CaliBeta/Control_PID_modular/README.md

# Control_PID_modular
Controlador PID analogo y digital para tres plantas de diferente respuesta. las ganancias se varían mediante potenciometros digitales
