CaliBeta/Control_PID_modular/Info/acciones_control.pdf

Proyecto Banco PID | 1

# Diseno sistema de control PID para la planta numero1

1. analisis de la planta en lazo abierto

La planta a controlar es un sistema en segundo orden cuya funcion de transferencia esta dada por:

1
s

2+s−2

R(s) | Y (s)

Graficando Los polos de la planta se analiza que el sistema es Inestable, con un polo en el semiplano positivo sin parte imaginaria. segun esto, la respuesta ante el escalon debe ser una exponencial hacia el infinito sin amortiguamiento.

los polos son:

s = −2

s = 1

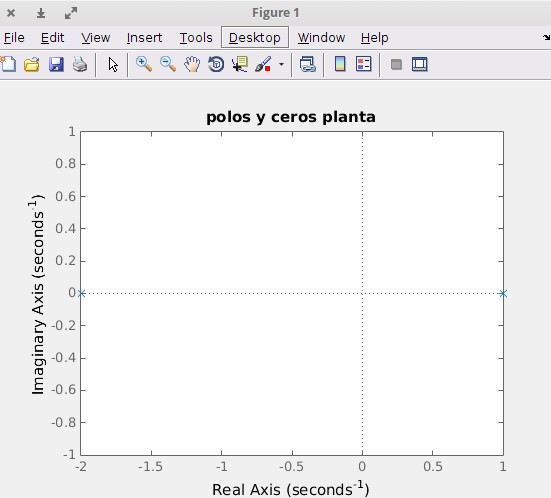
[picture p15: figure]

Con Matlab, se grafica la respuesta ante una entrada escalon unitario analizando que el sistema se Inestabiliza al infinito sin amortiguamiento:

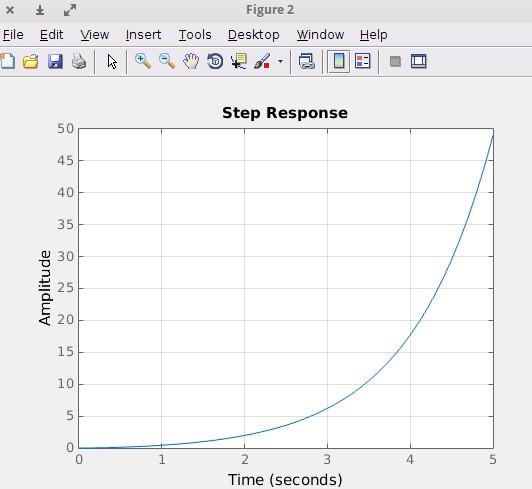
[picture p16: figure]

2. planta 1 con el controlador

Para controlar la planta, entonces realimentamos el sistema con el controlador PID:

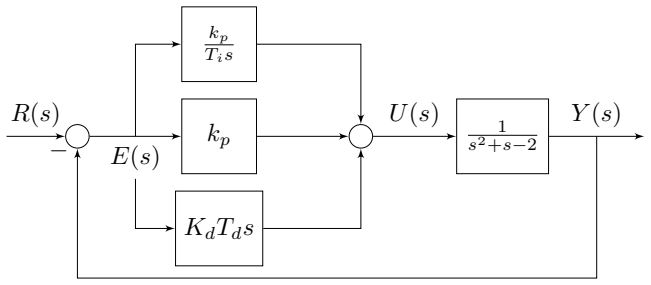
[picture p17: figure]
kp Tis; KdTds

Resolviendo los bloques del controlador:

kpTiTds

2+kpTis+kp
Tis

1
s

2+s−2

R(s)

E(s)

U(s) | Y (s)
−

Resolviendo la realimentacion:

## kpTiTd

s

## 2+kpTis+kp

## Tis

## 3+(Ti+kpTiTd

)s

## 2+(kpTi−2Ti )s+kp

R(s) | Y (s)

Dividiendo por Ti con el fin de dejar s

3
solo, se tiene la funcion de transferencia planta-controlador o controlada.

## kpTd

s

## 2+kps+

kp
Ti
s

## 3+(1+kpTd

)s

## 2+(kp−2)s+

kp
Ti
R(s) | Y (s)

nota: en este momento ya se tiene la funcion de transferencia de la planta con el bloque de control. es necesario hallar los parametros KpTiT d

3. Funcion de transferencia deseada

Segun las especificacion de diseno se requiere que el sistema responda con un tiempo de establecimiento T s deseado, ademas el sobrepaso deseado Mp.

Para esto se hace una funcion de transferencia deseada de segundo orden, para asi comparar con la planta controlada y definir los parametros de control.

Segn la forma canonica de un sistema de orden 2:

kwn

2
s

2+2ζwns+wn

2

El factor de amortiguamiento ζ lo definimos de 0.8 con el fin de que la respuesta sea subamortiguada con un bajo sobrepaso

ζ = 0.8

El tiempo de establecimiento o tiempo cuando la senal alcanza un error maximo del 2 porciento denminado Ts sera 5s, para esto se usa:

Ts = 4τ ⇒ τ =

1
ζwn ⇒ Ts =

4
ζwn

despejando wn:

wn =

4
ζTs ⇒ wn =

4
(0.8)(5) ⇒ wn = 1

reemplazando los valores en la forma canonica

kwn

2
s

2+2ζwns+wn

2 ⇒ | (1)(1)²
s
| 2+2(0.8)(1)s+1²

La funcion de transferencia deseada sera:

1
s

2+1.6s+1

si queremos comparar esta funcion de transferencia deseada de orden 2 con la funcion de transferencia planta-controlador o controlada de orden 3 no podriamos. tendriamos que aumentar el orden a la deseada. para esto colocamos un polo 10 veces mas alejado del ultimo polo de la deseada.

hallamos los polos de la deseada:

s = 0.8 ± 0.6j

entonces:

1
s
2+1.6s+1 ⇒ | 1
(s+0.8+0.6j)(s+8−0.6j)

un polo 10 veces mas alejado sin parte imaginaria y multiplicamos por el valor del polo en el numerador con el fin de mantener wn

2
tanto en el numerador y denominador. Aumentando el orden del sistema con el polo alejado:

1(8)
(s+0.8+0.6j)(s+0.8−0.6j)(s+8) ⇒ | 1(8)
(s

2+1.6s+1)(s+8)

la funcion de transferencia deseada sera entonces:

8
s

3+9.6s

2+13.8s+8

Graficando la respuesta al escalon de la deseada y la deseada aumentada con un polo 10 veces mayor, vemos que la respuesta deseada cumple los requerimientos y no son muy diferentes una con otra:

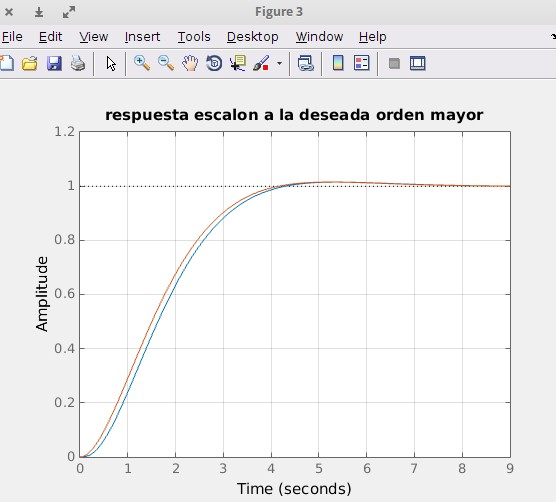
[picture p18: figure]

4. comparando la deseada aumentada con la planta-controlador

ya tenemos la funcion de transferencia controlada y la funcion de transferencia a la cual quermos llegar si las comparamos asi:

kpTds

2+kps+

kp
Ti
s

3+(1+kpTd)s

2+(kp−2)s+

kp
Ti
⇐⇒ | 8
s

3+9.6s

| 2+13.8s+8

comparando la ecuacion caracteristica o denominador:

s

3 + (1 + kpTd)s

2 + (kp − 2)s +

kp

### Ti ⇐⇒ s

3 + 9.6s

2 + 13.8s + 8

igualando tenemos que:

kp − 2 = 13.8 ⇒ kp = 13.8 + 2 ⇒ kp = 15.8

kp
Ti

= 8 ⇒ Ti =

kp
8 ⇒ Ti =

15.8
8

Ti = 1.975

1 + kpTd = 9.6 ⇒ Td =

9.6 − 1
kp

⇒ Td =

9.6 − 1
15.8

⇒ Td = 0.5443 con Simulink, se crea la simulacion del controlador-planta y un bloque que simula la saturacion de los amplifi-cadores operacionales. En el circuito electronico, si el esfuerzo de control supera el umbral de alimentacion de los Operacionales, estos daran como resuesta el voltaje maximo que los alimenta 10v

en la respuesta del Scope de la simulacion, se puede analizar la entrada escalon, la respuesta de la planta controlada y el esfuerzo de control que debe hacer el PID:

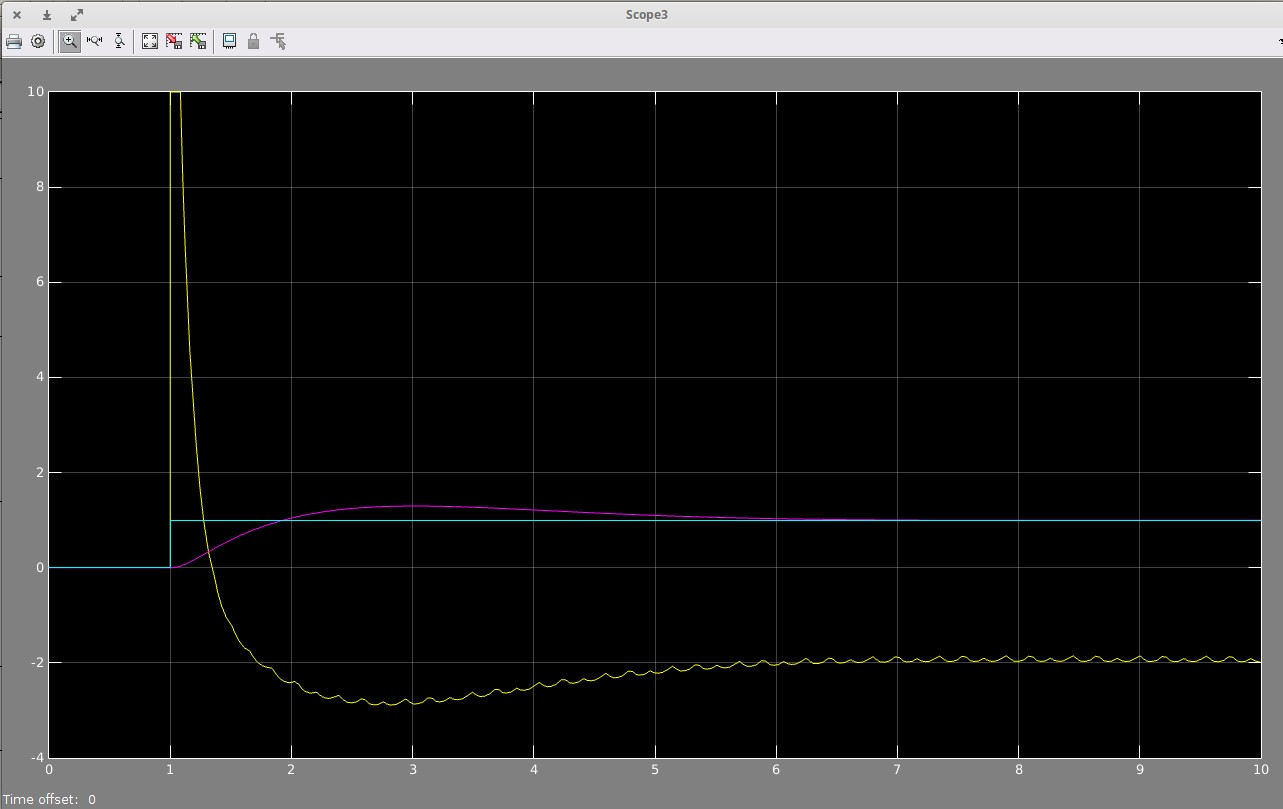
[picture p19: figure]

graficando la respuesta ante el escalon de la planta controlada con Matlab se puede aprecir que el sistema se estabiliza a 5s y el sobrepico maximo es aproximado al 10 porciento (V oltajeP ico ≈ 1.1). el sobrepico no es exacto devido que el esfuezo de control esta restringido por el voltaje de alimentacion de los operacionales:

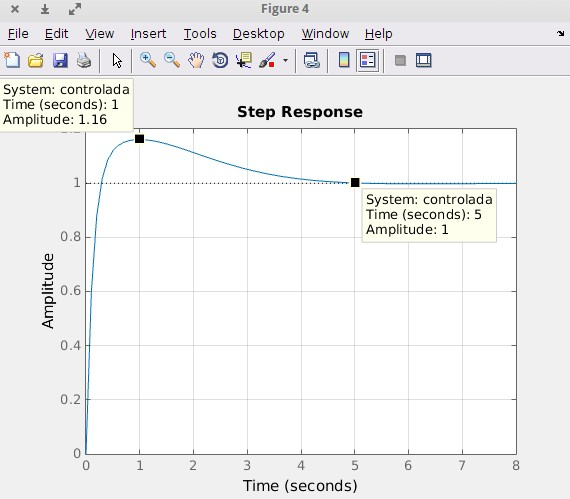
[picture p20: figure]

# Diseno sistema de control PID para la planta numero2

1. analisis de la planta en lazo abierto

La planta a controlar es un sistema en segundo orden cuya funcion de transferencia esta dada por:

4
s

2+s+2

R(s) | Y (s)

segun la forma canonica de un sistema de segundo orden:

kwn

2
s

2+2ζwns+wn
2

Es facil identificar que wn

2 = 2 en el denominador de la planta, por tanto la ganancia en el numerador es k = 2

Graficando Los polos de la planta se analiza que el sistema es Estable, con polos en el semiplano negativo y con parte imaginaria, por tanto la respueta ante el escalon debe ser subamortiguada.

los polos son:

s = −0.5000 ± 1.3229j

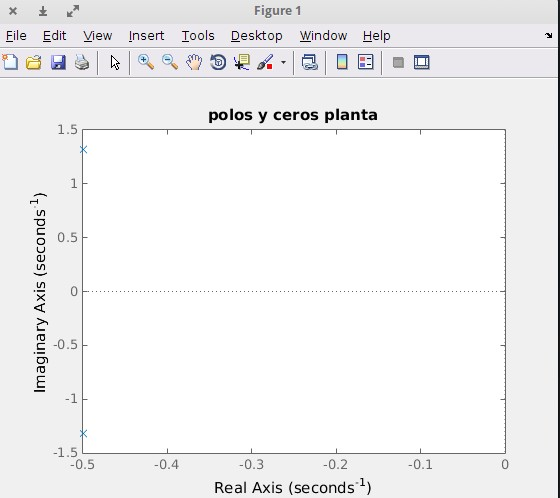
[picture p21: figure]

Con Matlab, se grafica la respuesta ante una entrada escalon unitario analizando que el sistema se estabiliza mas o menos en 8 segundos, y el voltaje pico es mayor a 2.5 v, tambien se aprecia un error de estado estacionario de 2 incluido por la gananancia de la planta k:

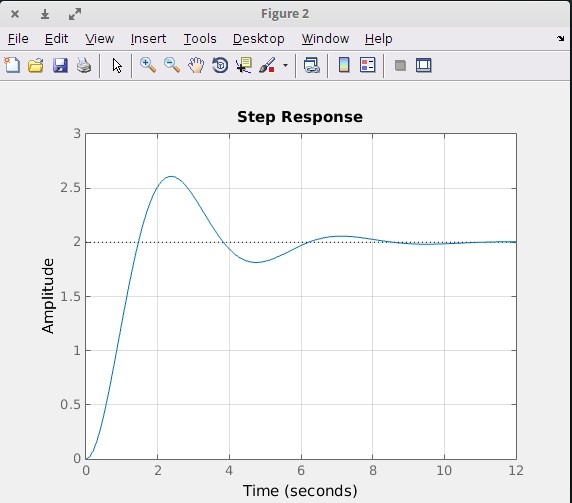
[picture p22: figure]

2. planta 2 con el controlador

Para mejorar la respuesta de la planta, entonces realimentamos el sistema con el controlador PID:

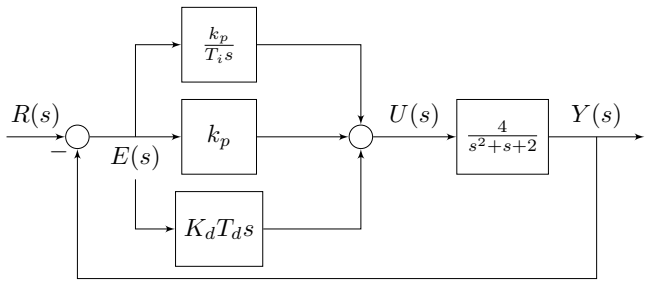
[picture p23: figure]
kp Tis; KdTds

Resolviendo los bloques del controlador:

kpTiTds

2+kpTis+kp
Tis

4
s

2+s+2

R(s)

E(s)

U(s) | Y (s)
−

Resolviendo la realimentacion:

## 4kpTiTd

s

## 2+4kpTis+4kp

## Tis

## 3+(Ti+4kpTiTd

)s

## 2+(4kpTi+2Ti )s+4kp

R(s) | Y (s)

Dividiendo por Ti con el fin de dejar s

3
solo, se tiene la funcion de transferencia planta-controlador o controlada.

## 4kpTd

s

## 2+4kps+

4kp
Ti
s

## 3+(1+4kpTd

)s

## 2+(4kp+2)s+

4kp
Ti
R(s) | Y (s)

nota: en este momento ya se tiene la funcion de transferencia de la planta con el bloque de control. es necesario hallar los parametros KpTiT d

3. Funcion de transferencia deseada

Segun las especificacion de diseno se requiere que el sistema responda con un tiempo de establecimiento T s deseado, ademas el sobrepaso deseado Mp.

en este caso el controlador tiene que hacer que la planta se estabilice en menos tiempo Ts < 8s, con un error de estado estacionario nulo, lo que indica una ganancia de 1, y un voltaje pico menor a al 10 porciento del voltaje final de estabilidad.

Para esto se hace una funcion de transferencia deseada de segundo orden, para asi comparar con la planta controlada y definir los parametros de control.

Segn la forma cannica de un sistema de orden 2:

kwn

2
s

2+2ζwns+wn
2

El factor de amortiguamiento ζ lo definimos de 0.8 con el fin de que la respuesta sea casi subamortiguada

ζ = 0.8

El tiempo de establecimiento o tiempo cuando la seal alcanza un error maximo del 2 porciento denminado Ts sera 5s, si se recuerda la funcion de transferencia deseada de la planta anterior, es valida para este caso. para esto se usa:

Ts = 4τ ⇒ τ =

1
ζwn ⇒ Ts =

4
ζwn

despejando wn:

wn =

4
ζTs ⇒ wn =

4
(0.8)(5) ⇒ wn = 1

reemplazando los valores en la forma canonica

kwn

2
s

2+2ζwns+wn

2 ⇒ | (1)(1)²
s
| 2+2(0.8)(1)s+1²

La funcion de transferencia deseada sera:

1
s

2+1.6s+1

si queremos comparar esta funcion de transferencia deseada de orden 2 con la funcion de transferencia planta-controlador o controlada de orden 3 no podriamos. tendriamos que aumentar el orden a la deseada. para esto colocamos un polo 10 veces mas alejado del ultimo polo de la deseada.

hallamos los polos de la deseada:

s = 0.8 ± 0.6j

entonces:

1
s
2+1.6s+1 ⇒ | 1 (s+0.8+0.6j)(s+8−0.6j)

un polo 10 veces mas alejado sin parte imaginaria y multiplicamos por el valor del polo en el numerador con el fin de mantener wn

2
tanto en el numerador y denominador. Aumentando el orden del sistema con el polo alejado:

1(8)

(s+0.8+0.6j)(s+0.8−0.6j)(s+8) ⇒ | 1(8)
(s
| 2+1.6s+1)(s+8)

la funcion de transferencia deseada sera entonces:

8
s

3+9.6s

2+13.8s+8

Graficando la respuesta al escalon de la deseada y la deseada aumentada con un polo 10 veces mayor, vemos que la respuesta deseada cumple los requerimientos y no son muy diferentes una con otra:

4. comparando la deseada aumentada con la planta-controlador

ya tenemos la funcion de transferencia controlada y la funcion de transferencia a la cual quermos llegar si las comparamos asi:

4kpTds

2+4kps+

4kp
Ti
s

3+(1+4kpTd)s

2+(4kp+2)s+

4kp
Ti
⇐⇒ | 8
s

3+9.6s

| 2+13.8s+8

comparando la ecuacion caracteristica o denominador:

s

3 + (1 + 4kpTd)s

2 + (4kp + 2)s +

4kp

### Ti ⇐⇒ s

3 + 9.6s

2 + 13.8s + 8

igualando tenemos que:

4kp + 2 = 13.8 ⇒ kp =

13.8−2
4 | ⇒ | kp = 2.95

4kp
Ti

= 8 ⇒ Ti =

4kp
8 ⇒ Ti =

4(2.95)
8

Ti = 1.475

1 + 4kpTd = 9.6 ⇒ Td =

9.6 − 1
4kp

⇒ Td =

9.6 − 1
4(2.95) ⇒ Td = 0.7288

con Simulink, se crea la simulacion del controlador-planta y un bloque que simula la saturacion de los amplifi-cadores operacionales. En el circuito electronico, si el esfuerzo de control supera el umbral de alimentacion de los Operacionales, estos daran como resuesta el voltaje maximo que los alimenta 10v

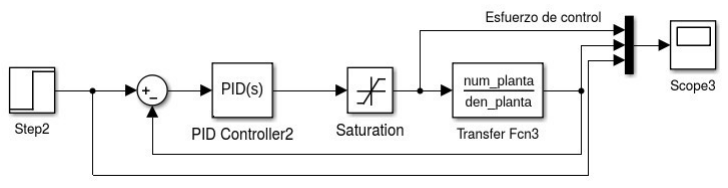
[picture p24: figure]

en la respuesta del Scope de la simulacion, se puede analizar la entrada escalon, la respuesta de la planta controlada y el esfuerzo de control que debe hacer el PID:

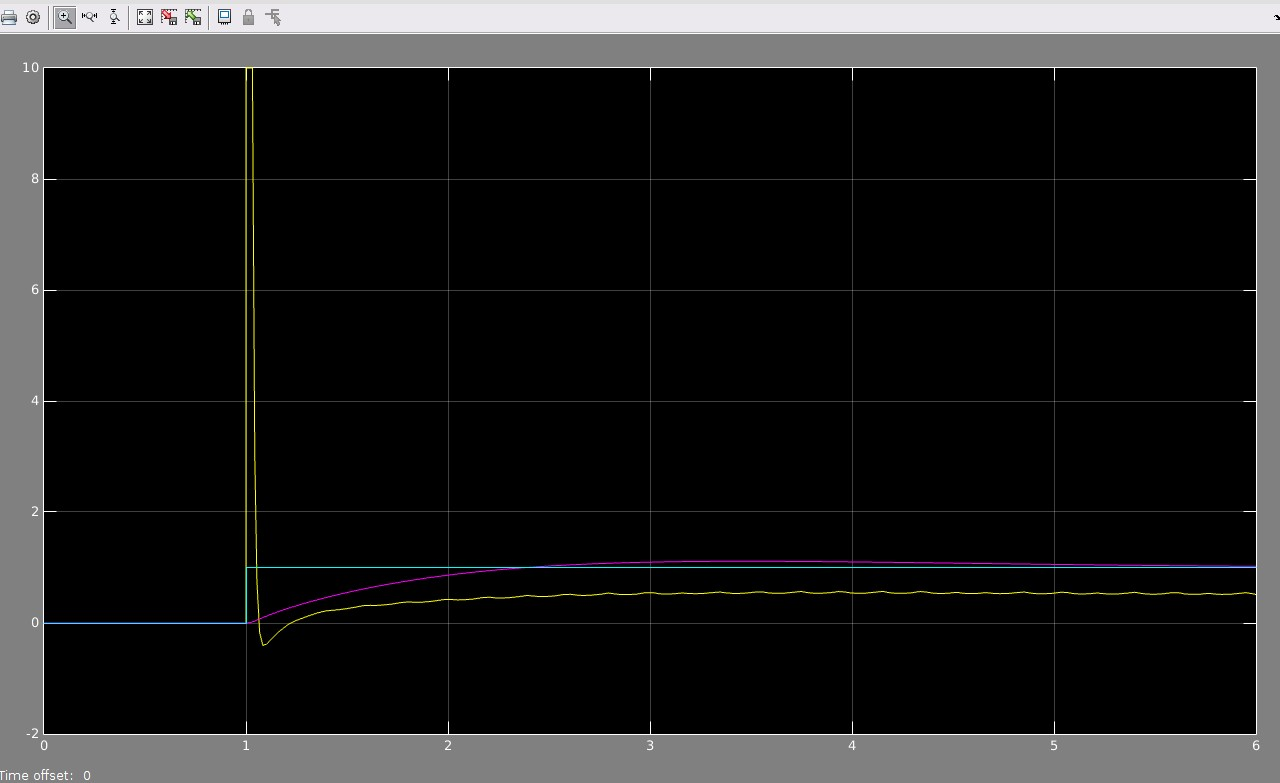
[picture p25: figure]

graficando la respuesta ante el escalon de la planta controlada con Matlab se puede aprecir que el sistema se estabiliza a 5s y el sobrepico maximo es menor 10 porciento (V oltajeP ico = 0.98v). el sobrepico no es exacto devido que el esfuezo de control esta restringido por el voltaje de alimentacion de los operacionales:

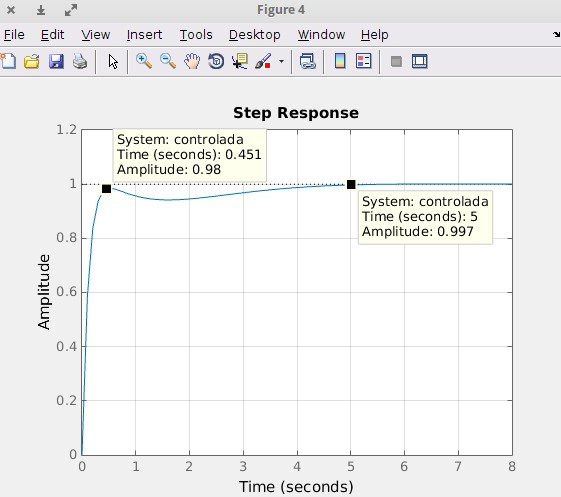
[picture p26: figure]

# Diseno sistema de control PID para la planta numero3

1. analisis de la planta en lazo abierto

La planta a controlar es un sistema en segundo orden cuya funcion de transferencia esta dada por:

1
5.04s

2+5s+1

R(s) | Y (s)

segun la forma canonica de un sistema de segundo orden:

kwn

2
s

2+2ζwns+wn
2

Es facil identificar que wn

2 = 1 en el denominador de la planta, por tanto la ganancia en el numerador es k = 1

Graficando Los polos de la planta se analiza que el sistema es Estable, con polos en el semiplano negativo y sin parte imaginaria, por tanto la respuesta ante el escalon no tiene amortiguamiento.

los polos son:

s = −0.7143

s = −0.2778

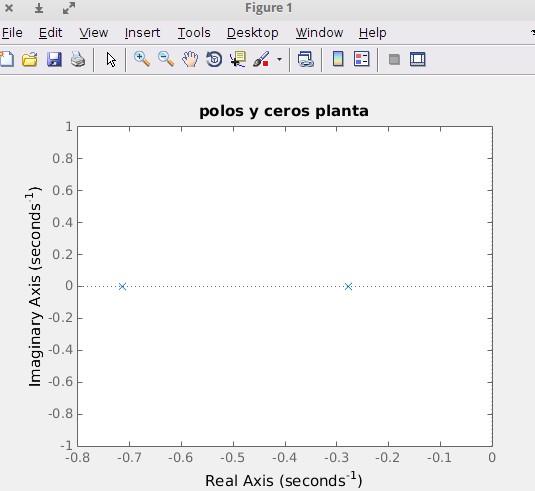
[picture p27: figure]

Con Matlab, se grafica la respuesta ante una entrada escalon unitario, analizando que el sistema es una planta lenta, se estabiliza en un tiempo mayor a 20 segundos, y no tiene sobrepaso, tambien se aprecia un error de estado estacionario nulo ya que la gananancia de la planta k es 1:

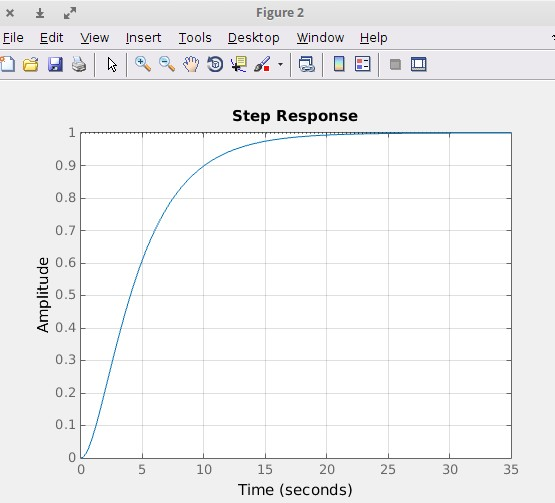
[picture p28: figure]

2. planta 3 con el controlador

Para mejorar la respuesta de la planta, entonces realimentamos el sistema con el controlador PID:

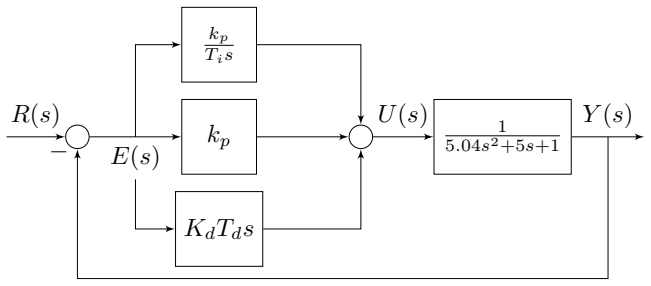
[picture p29: figure]
kp Tis; KdTds

Resolviendo los bloques del controlador:

kpTiTds

2+kpTis+kp
Tis

1
5.04s

2+5s+1

R(s)

E(s)

U(s) | Y (s)
−

Resolviendo la realimentacion:

## kpTiTd

s

## 2+kpTis+kp

## 5.04Tis

## 3+(5.0Ti+kpTiTd

)s

## 2+(kpTi+Ti )s+kp

R(s) | Y (s)

Dividiendo por 5.04Ti con el fin de dejar s

3
solo, se tiene la funcion de transferencia planta-controlador o controlada.

kpTd
5.04 s

2+

kp
5.04s+

kp
5.04Ti
s

3+( 5.0
5.04+

kpTd
5.04 )s

2+( kp
5.04+

1
5.04)s+

kp
5.04Ti
R(s) | Y (s)

nota: en este momento ya se tiene la funcion de transferencia de la planta con el bloque de control. es necesario hallar los parametros KpTiT d

3. Funcion de transferencia deseada

Segun las especificacion de diseno se requiere que el sistema responda con un tiempo de establecimiento T s deseado, ademas el sobrepaso deseado Mp.

en este caso el controlador tiene que hacer que la planta se estabilice en menos tiempo Ts < 20s, con un error de estado estacionario nulo, lo que indica una ganancia de 1, y un voltaje pico menor a al 10 porciento del voltaje final de estabilidad.

Para esto se hace una funcion de transferencia deseada de segundo orden, para asi comparar con la planta controlada y definir los parametros de control.

Segn la forma cannica de un sistema de orden 2:

kwn

2
s

2+2ζwns+wn

2

El factor de amortiguamiento ζ lo definimos de 0.8 con el fin de que la respuesta sea casi subamortiguada

ζ = 0.8

El tiempo de establecimiento o tiempo cuando la seal alcanza un error maximo del 2 porciento, dicho tiempo Ts lo definimos como 5s, mas de la mitad del tiempo de la planta sin controlador. exactamnte la misma respuesta deseada de las plantas anteriores. para esto se usa:

Ts = 4τ ⇒ τ =

1
ζwn ⇒ Ts =

4
ζwn

despejando wn:

wn =

4
ζTs ⇒ wn =

4
(0.8)(5) ⇒ wn = 1

reemplazando los valores en la forma canonica

kwn

2
s

2+2ζwns+wn

2 ⇒ | (1)(1)²
s
| 2+2(0.8)(1)s+1²

La funcion de transferencia deseada sera:

1
s

2+1.6s+1

si queremos comparar esta funcion de transferencia deseada de orden 2 con la funcion de transferencia planta-controlador o controlada de orden 3 no podriamos. tendriamos que aumentar el orden a la deseada. para esto colocamos un polo 10 veces mas alejado del ultimo polo de la deseada.

hallamos los polos de la deseada:

s = 0.8 ± 0.6j

entonces:

1
s
2+1.6s+1 ⇒ | 1 (s+0.8+0.6j)(s+8−0.6j)

un polo 10 veces mas alejado sin parte imaginaria y multiplicamos por el valor del polo en el numerador con el fin de mantener wn

2
tanto en el numerador y denominador. Aumentando el orden del sistema con el polo alejado:

1(8)

(s+0.8+0.6j)(s+0.8−0.6j)(s+8) ⇒ | 1(8)
(s
| 2+1.6s+1)(s+8)

la funcion de transferencia deseada sera entonces:

8
s

3+9.6s

2+13.8s+8

Graficando la respuesta al escalon de la deseada y la deseada aumentada con un polo 10 veces mayor, vemos que la respuesta deseada cumple los requerimientos y no son muy diferentes una con otra:

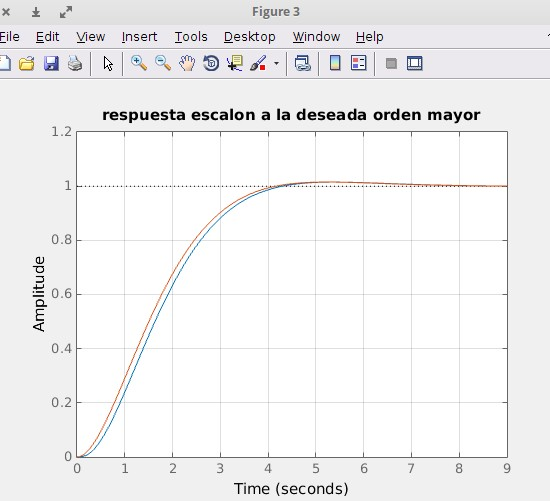
[picture p30: figure]

4. comparando la deseada aumentada con la planta-controlador

ya tenemos la funcion de transferencia controlada y la funcion de transferencia a la cual quermos llegar si las comparamos asi:

kpTd
5.04 s

2+

kp
5.04 s+

kp
5.04Ti
s

3+( 5.0
5.04 +

kpTd
5.04 )s

2+( kp
5.04 + 1
5.04 )s+

kp
5.04Ti
⇐⇒ | 8
s

3+9.6s

| 2+13.8s+8

comparando la ecuacion caracteristica o denominador:

s

3 + ( 5.0
5.04 +

kpTd
5.04 )s

2 + ( kp
5.04 +

1
5.04 )s +

kp
5.04Ti ⇐⇒ s

3 + 9.6s

2 + 13.8s + 8

igualando tenemos que:

kp
5.04 +

1
5.04 = 13.8 ⇒ kp = (13.8 −

1
5.04 )(5.04) ⇒ kp = 68.552

kp
5.04Ti

= 8 ⇒ Ti =

kp
(5.04)(8) ⇒ Ti =

68.552
(5.04)(8) Ti = 1.7002

5.0
5.04 +

kpTd
5.04 = 9.6 ⇒ Td =

(9.6− 5.0
5.04 )(5.04)
kp | ⇒ Td =

(9.6− 5.0
5.04 )(5.04)
68.552 | ⇒ | Td = 0.6329

con Simulink, se crea la simulacion del controlador-planta y un bloque que simula la saturacion de los amplifi-cadores operacionales. En el circuito electronico, si el esfuerzo de control supera el umbral de alimentacion de los Operacionales, estos daran como resuesta el voltaje maximo que los alimenta 10v

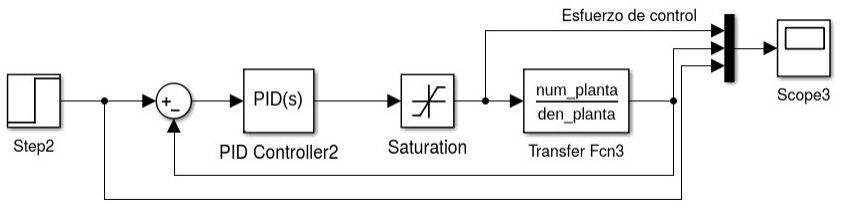
[picture p31: figure]

en la respuesta del Scope de la simulacion, se puede analizar la entrada escalon, la respuesta de la planta controlada y el esfuerzo de control que debe hacer el PID, se puede apreciar la saturacion que tendrian los operacionales:

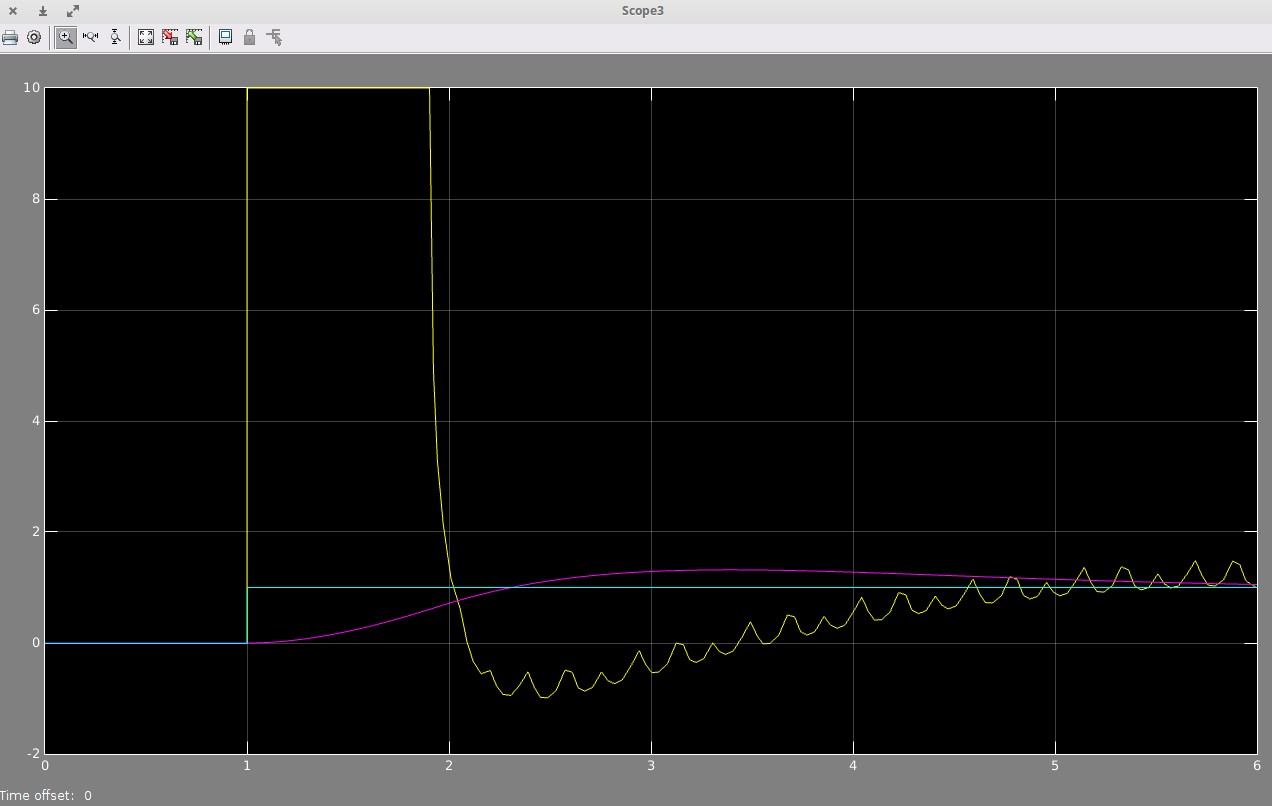
[picture p32: figure]

graficando la respuesta ante el escalon de la planta controlada con Matlab se puede apreciar que el sistema se estabiliza a 5s y el sobrepico maximo es menor 10 porciento (V oltajeP ico = 1.05v). el sobrepico no es exacto devido que el esfuezo de control esta restringido por el voltaje de alimentacion de los operacionales:

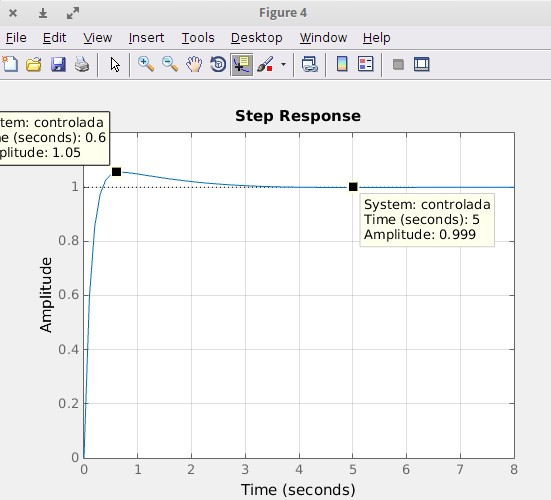
[picture p33: figure]
