CaliBeta/Control_PID_modular/Hardware/Eagle/Fuente de poder/Fuente lineal +12V,-12V,+5V - 500mA(PCB).png

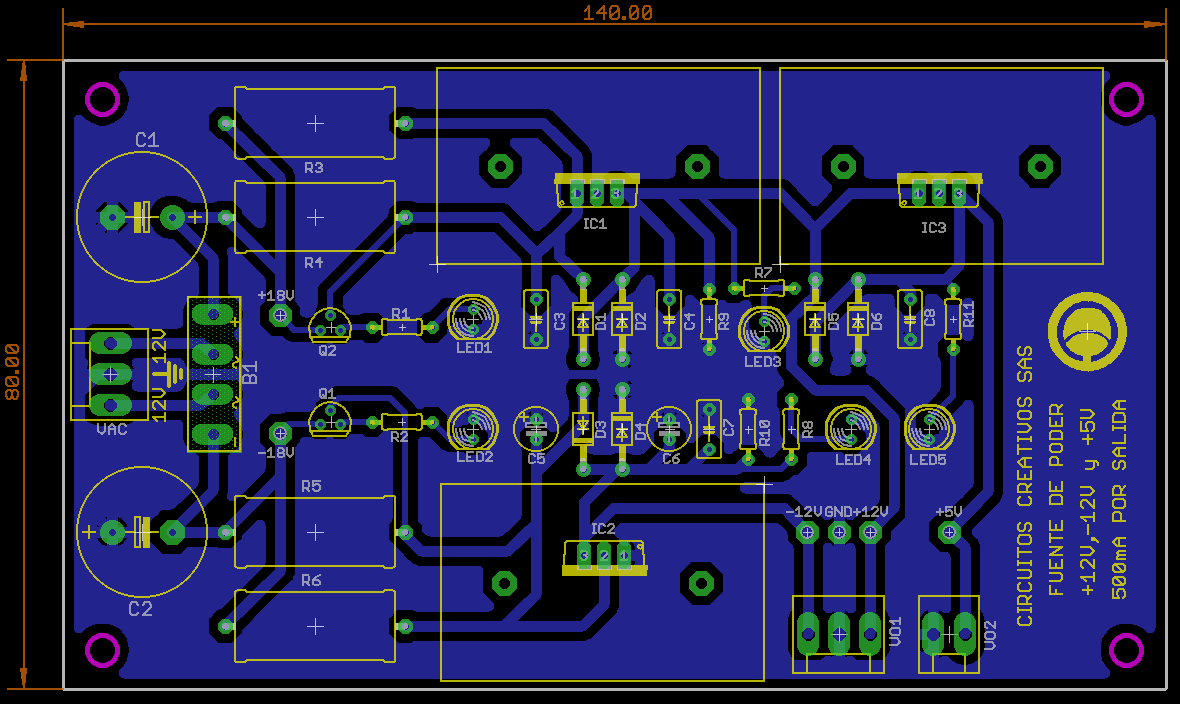
Hardware/Eagle/Fuente de poder/Fuente lineal +12V,-12V,+5V - 500mA(PCB).png
