CaliBeta/Control_PID_modular/Hardware/Eagle/Generador de funciones/Generador de funciones(PCB).png

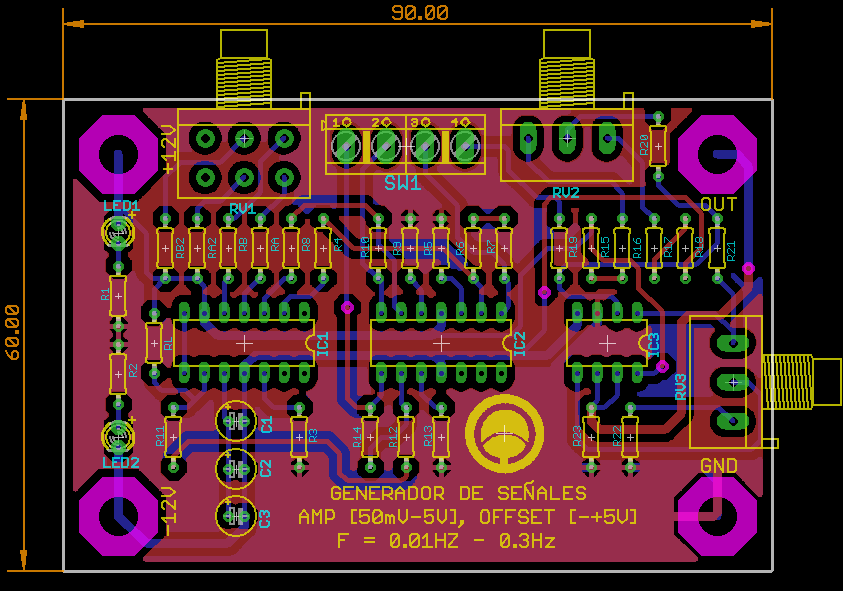
Hardware/Eagle/Generador de funciones/Generador de funciones(PCB).png
