CaliBeta/Control_PID_modular/Hardware/Eagle/Generador de funciones/Generador de funciones.png

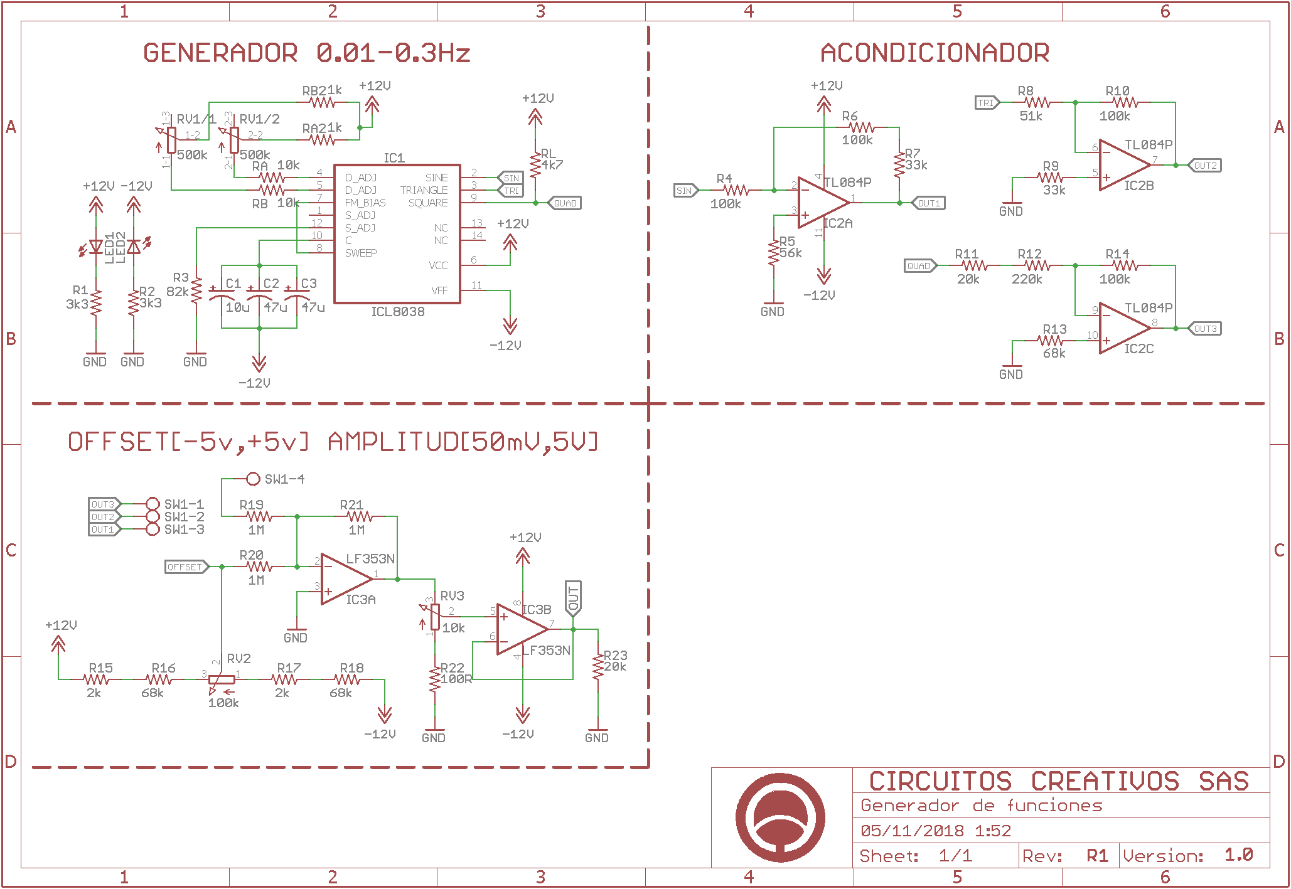
Hardware/Eagle/Generador de funciones/Generador de funciones.png
