CaliBeta/Control_PID_modular/Hardware/Eagle/Planta_1 inestable/Planta_1 inestable(PCB).png

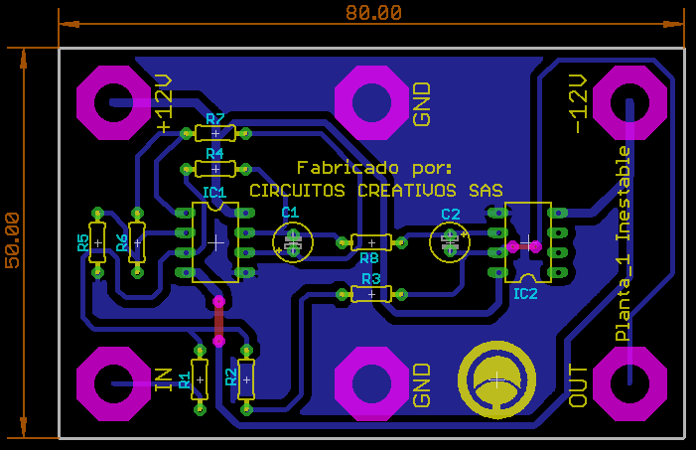
Hardware/Eagle/Planta_1 inestable/Planta_1 inestable(PCB).png
