CaliBeta/Control_PID_modular/Hardware/Eagle/Planta_1 inestable/Planta_1 inestable.png

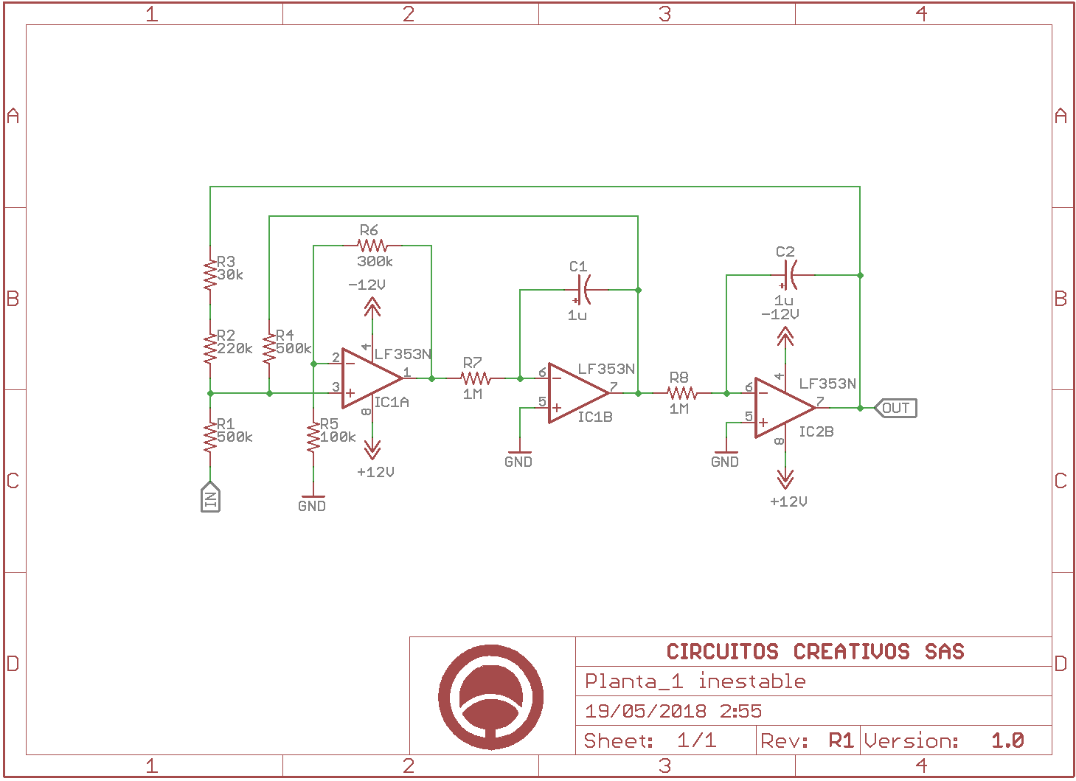
Hardware/Eagle/Planta_1 inestable/Planta_1 inestable.png
