CaliBeta/Control_PID_modular/Hardware/Eagle/Planta_2 subamortiguada/Planta_2 subamortiguada.png

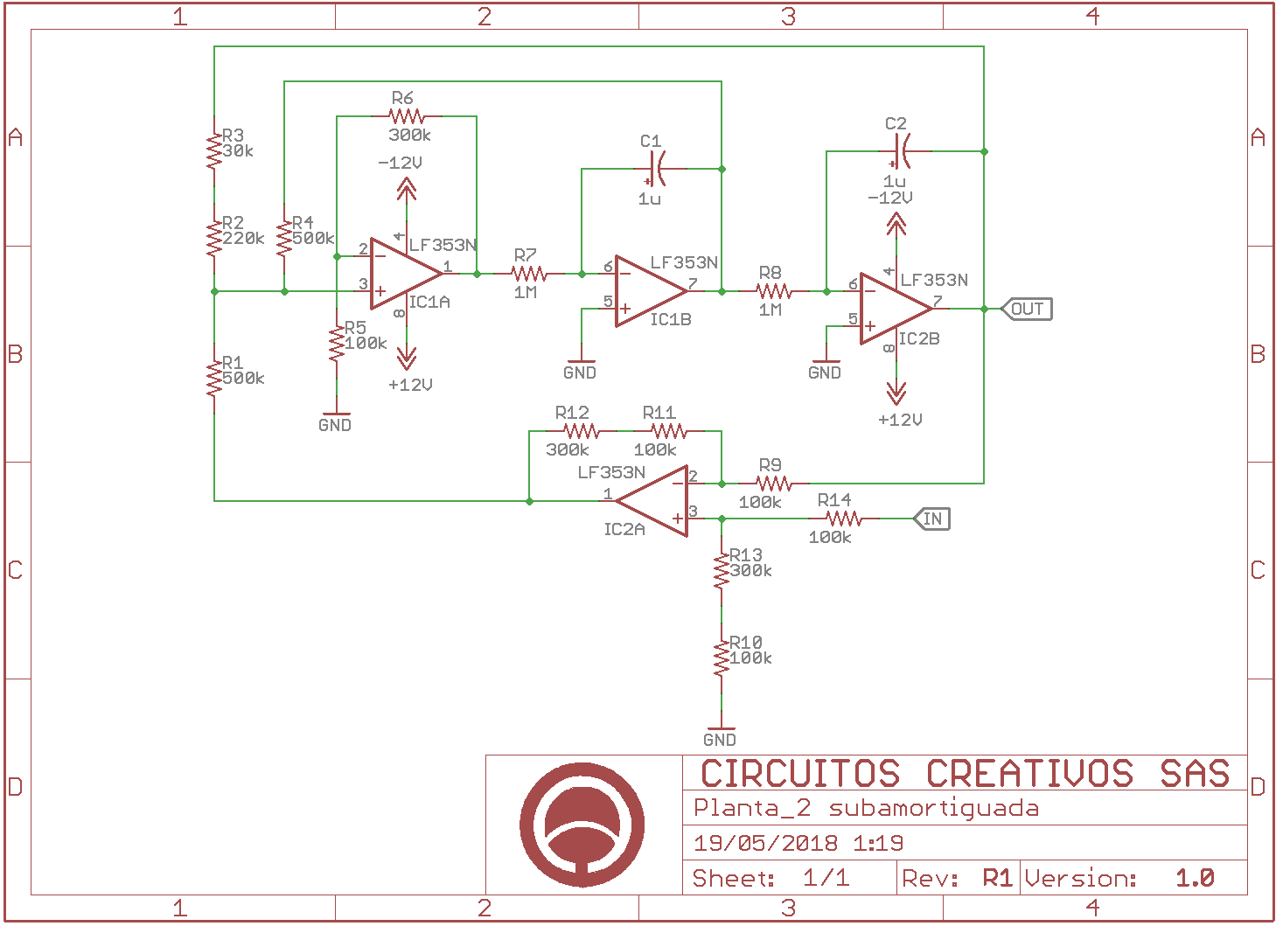
Hardware/Eagle/Planta_2 subamortiguada/Planta_2 subamortiguada.png
