CaliBeta/Control_PID_modular/Hardware/Eagle/Planta_3 sobreamortiguada/Planta_3 sobreamortiguada.png

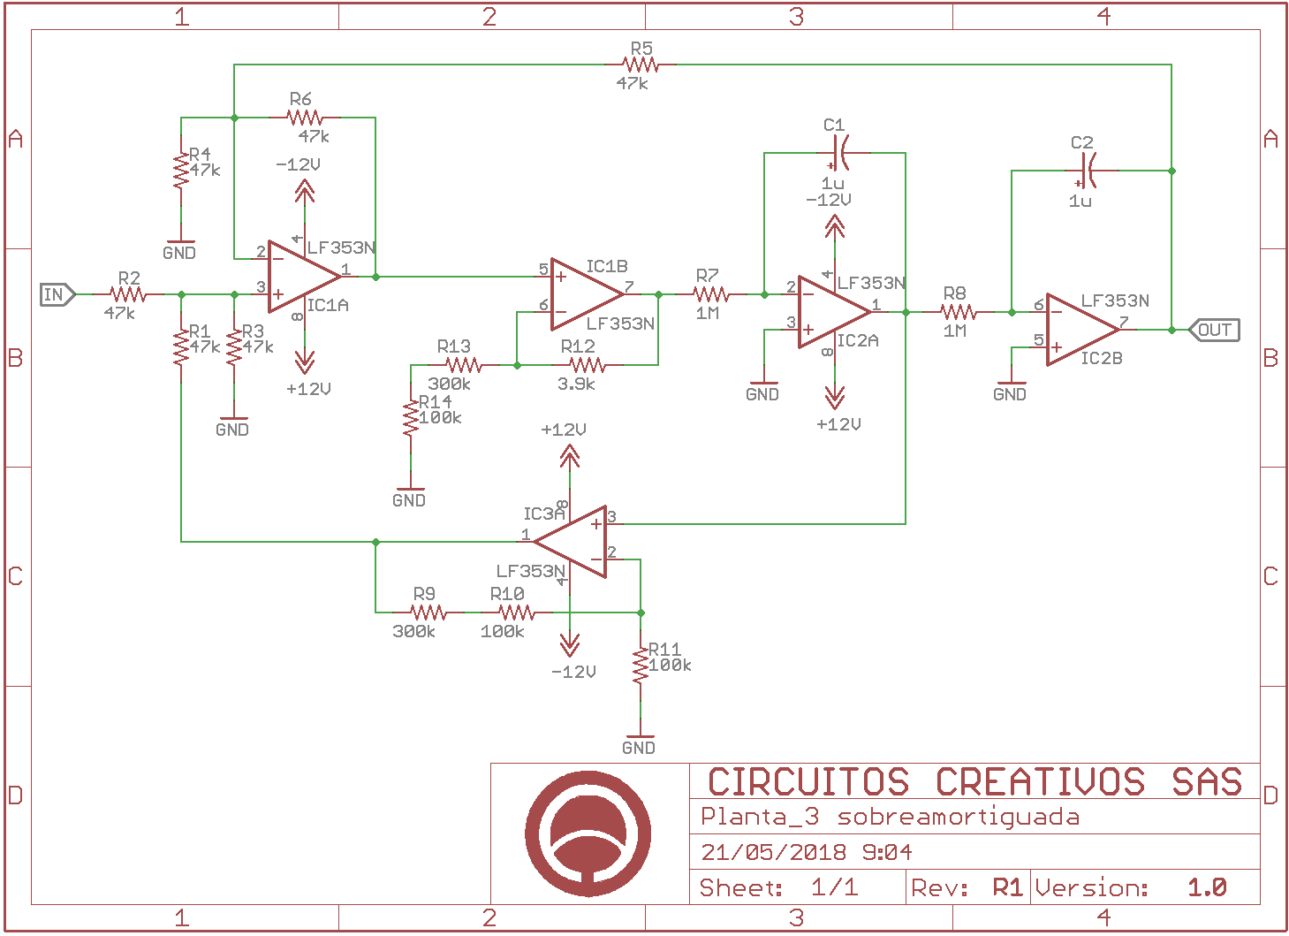
Hardware/Eagle/Planta_3 sobreamortiguada/Planta_3 sobreamortiguada.png
