CaliBeta/Control_PID_modular/Info/Imagenes/Fuente lineal +12V,-12V,+5V - 500mA.png

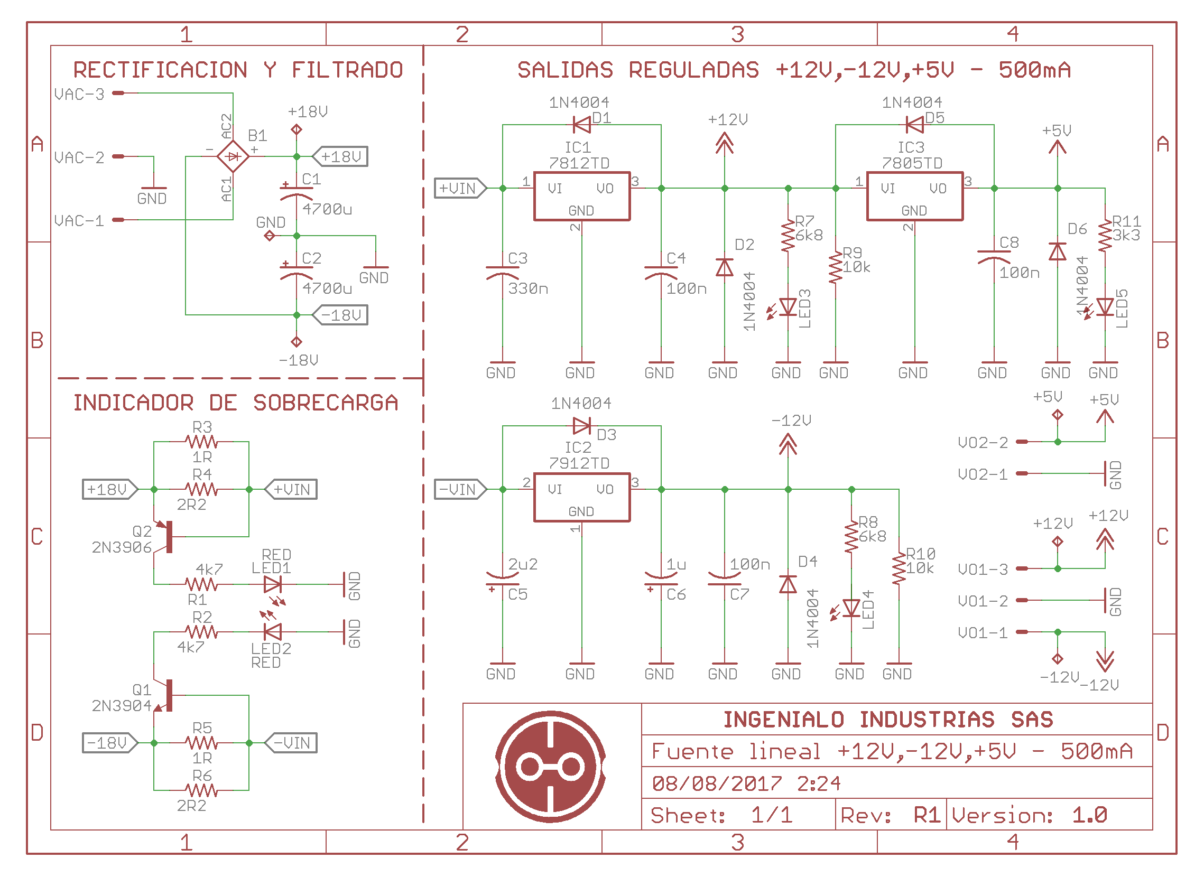
Info/Imagenes/Fuente lineal +12V,-12V,+5V - 500mA.png
