CaliBeta/Control_PID_modular/Info/Imagenes/Planta 1.jpg

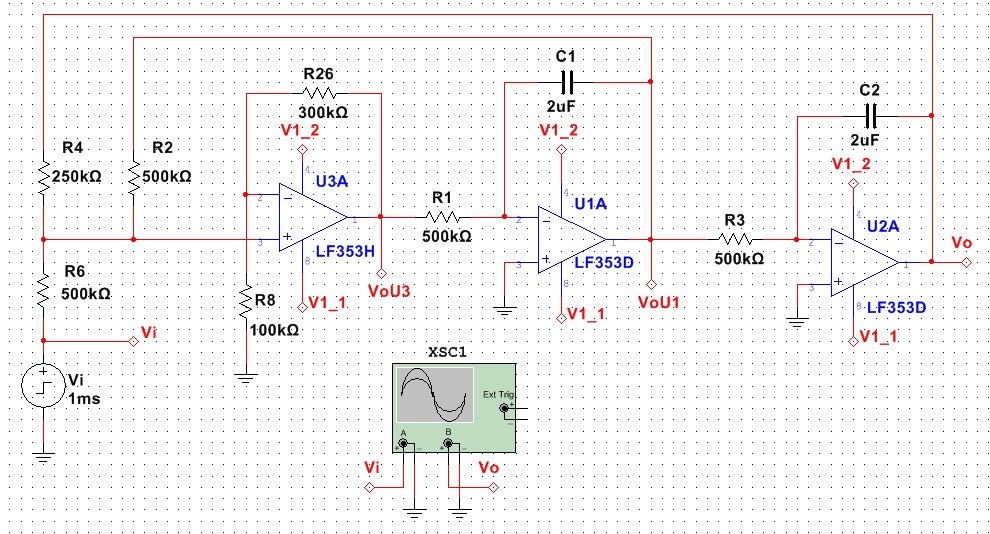
Info/Imagenes/Planta 1.jpg
