CaliBeta/Control_PID_modular/Info/Imagenes/Planta 2.jpg

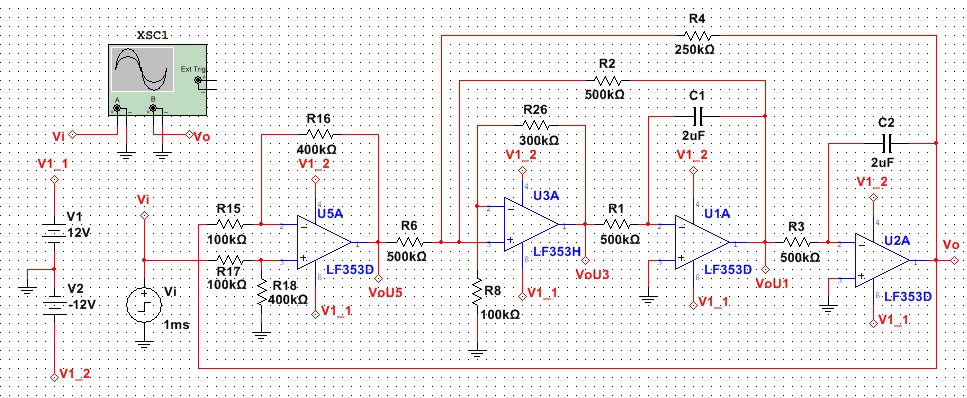
Info/Imagenes/Planta 2.jpg
