CaliBeta/Control_PID_modular/Info/Imagenes/Planta 3.jpg

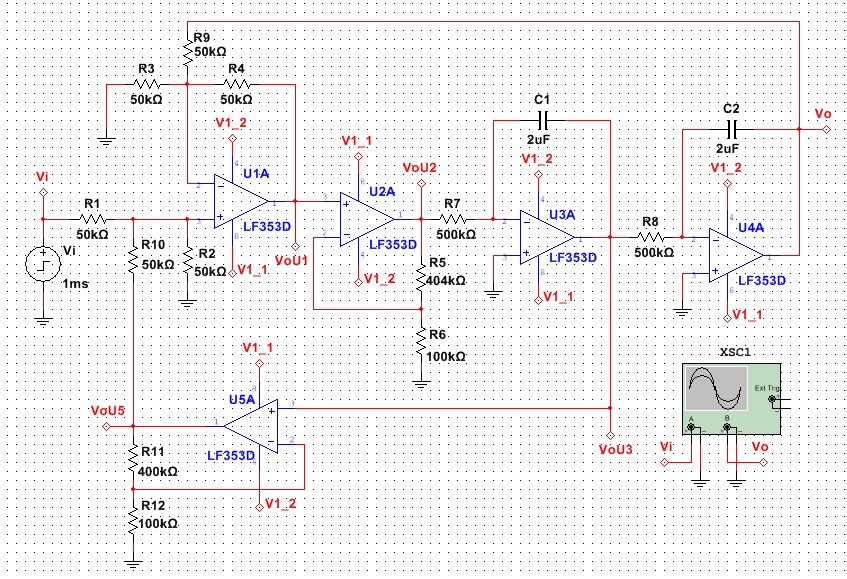
Info/Imagenes/Planta 3.jpg
