CaliBeta/Control_PID_modular/Info/Imagenes/Salida Planta 1.jpg

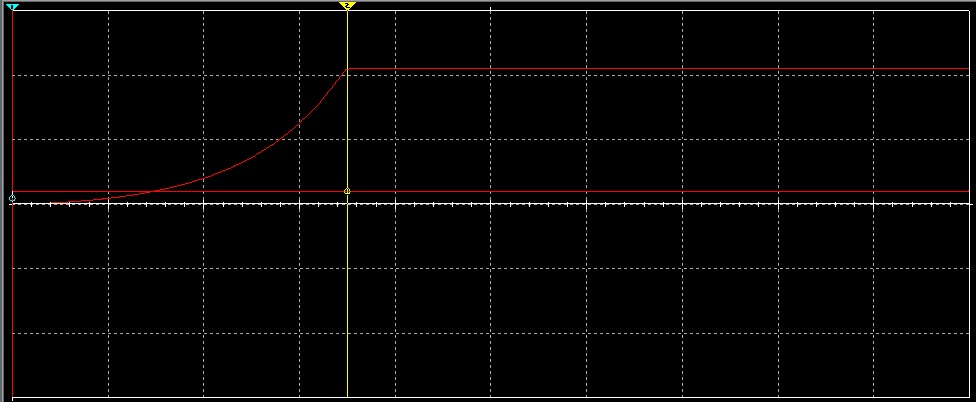
Info/Imagenes/Salida Planta 1.jpg
