CaliBeta/Control_PID_modular/Info/Imagenes/Salida Planta 2.jpg

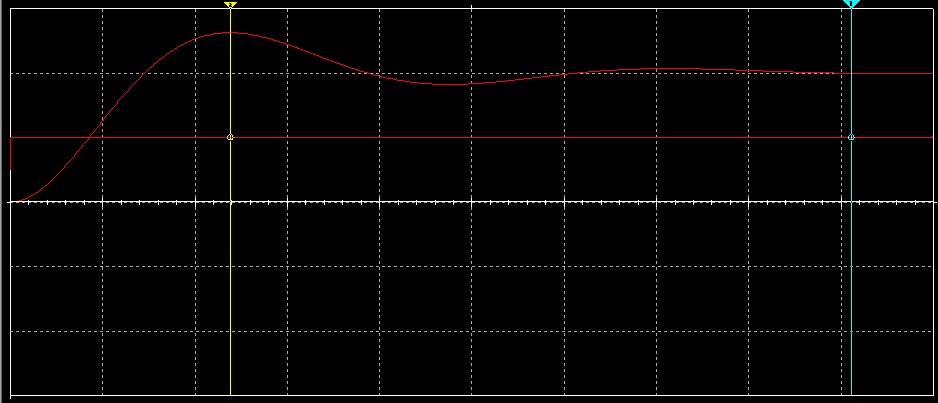
Info/Imagenes/Salida Planta 2.jpg
