CaliBeta/Control_PID_modular/Info/Imagenes/Salida Planta 3.jpg

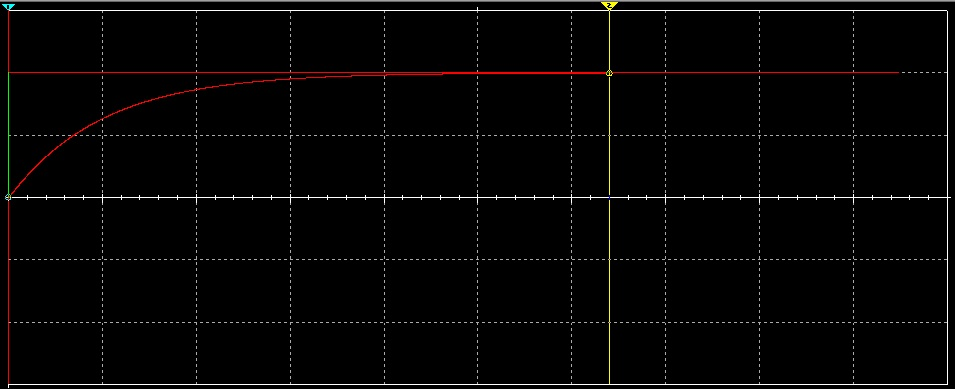
Info/Imagenes/Salida Planta 3.jpg
