CaliBeta/Control_PID_modular/Info/Imagenes/simulink_planta3.jpg

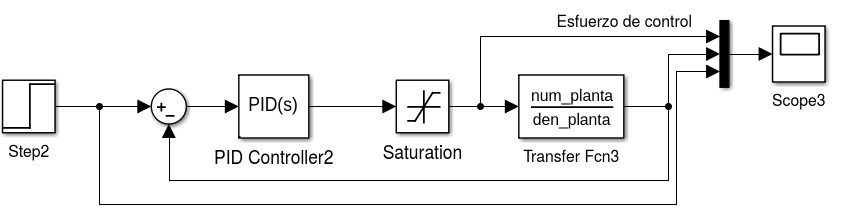
Info/Imagenes/simulink_planta3.jpg
