CaliBeta/Control_PID_modular/Simulaciones/Proteus/Fuente de poder lineal/fuente lineal +12v,-12v,+5v-1a.pdf

V1

## VAC1

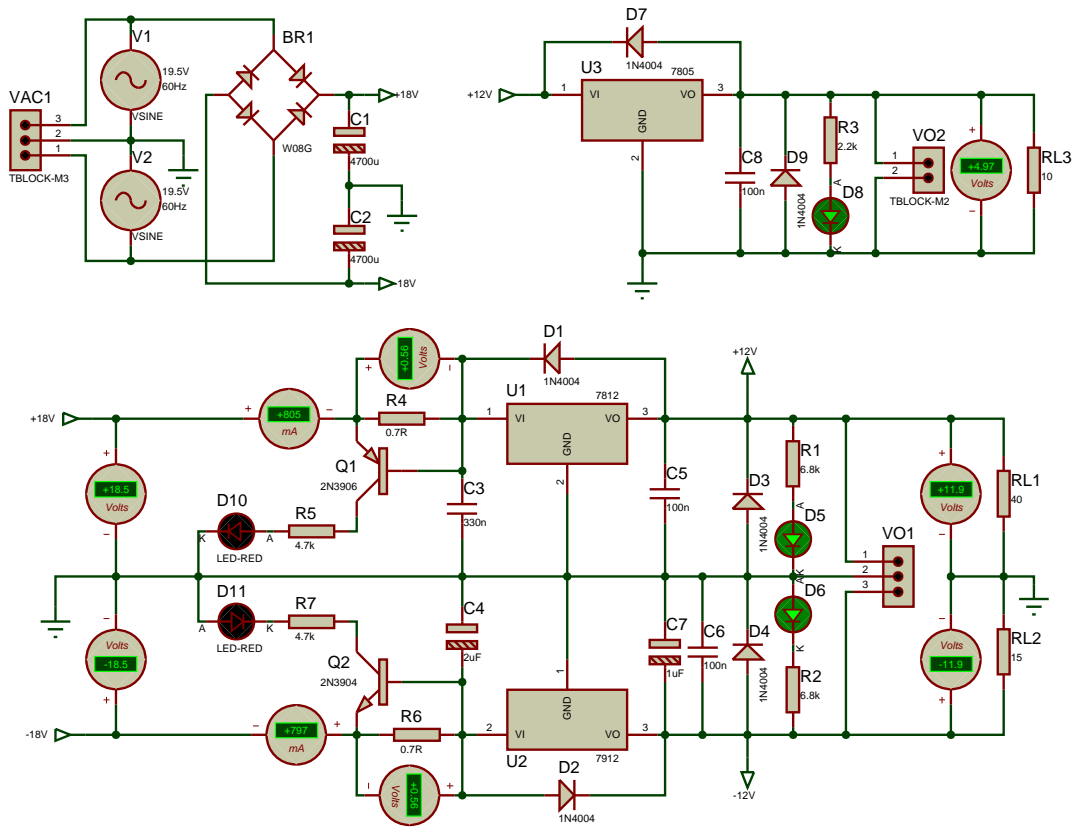
[picture p53: page 1]
