CaliBeta/Control_PID_modular/(list of files, drawings)

Other design files:
Simulaciones/Multisim/Control_Planta 1.ms14
Simulaciones/Multisim/Control_Planta 2.ms14
Simulaciones/Multisim/Control_Planta 3.ms14
Simulaciones/Multisim/Planta 1.ms14
Simulaciones/Multisim/Planta 2.ms14
Simulaciones/Multisim/Planta 3.ms14
Simulaciones/Proteus/Controldador PID digital/Etapa adecuacion de señales de entrada.pdsprj
Simulaciones/Proteus/Controldador PID digital/Salida analogica a partir de PWM.pdsprj
Simulaciones/Proteus/Fuente de poder lineal/Fuente lineal +12V,-12V,+5V-1A.pdsprj
Simulaciones/Proteus/Generador de señales/Generador de funciones etapa_01.pdsprj
Simulaciones/Proteus/Generador de señales/Generador de funciones etapa_02.pdsprj
Simulaciones/Proteus/Generador de señales/Generador de funciones etapa_03.pdsprj
Simulaciones/Proteus/Generador de señales/Generador de funciones etapa_final.pdsprj
