CaliBeta/Control_PID_modular/Hardware/Eagle/Controlador PID digital/Controlador PID digital.brd

## EAGLE design Hardware/Eagle/Controlador PID digital/Controlador PID digital.brd (2019-01-15)

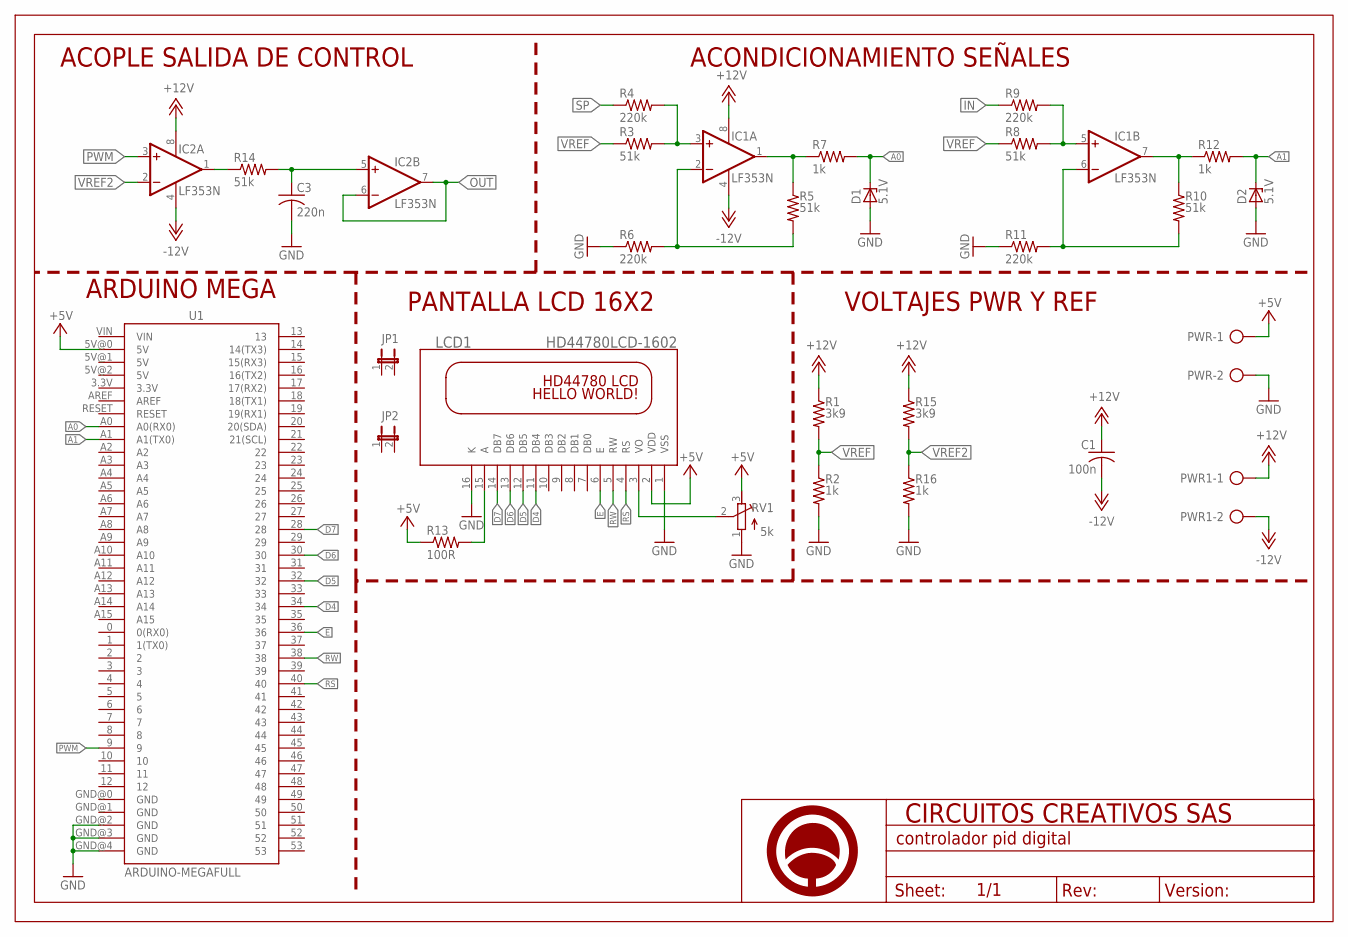
[picture p54: schematic Controlador PID digital.sch]

Parts:
C1: 100n; C025-025X050
C3: 220n; C050-030X075
D1, D2: 5.1V; DO41Z10
IC1, IC2: LF353N; DIL08
JP1, JP2: JP1E; JP1
LCD1: HD44780LCD-1602; LCD1602
PWR, PWR1: AK500/2
R1, R15: 3k9; 0204/7
R2, R7, R12, R16: 1k; 0204/7
R3, R5, R8, R10, R14: 51k; 0204/7
R4, R6, R9, R11: 220k; 0204/7
R13: 100R; 0204/7
RV1: 5k; RTRIM3296W
U1: ARDUINO-MEGAFULL; ARDUINO_MEGA
U$1: A4_HORIZONTAL; LOGO

Connections:
+5V: LCD1.2 (VDD), PWR.1, R13.1, RV1.3 (E), U1.5V@0 (5V)
+12V: C1.1, IC1.8 (V+), IC2.8 (V+), PWR1.1, R1.1, R15.1
-12V: C1.2, IC1.4 (V-), IC2.4 (V-), PWR1.2
A0: D1.C, R7.2, U1.A0 (A0(RX0))
A1: D2.C, R12.2, U1.A1 (A1(TX0))
D4: LCD1.11 (DB4), U1.34
D5: LCD1.12 (DB5), U1.32
D6: LCD1.13 (DB6), U1.30
D7: LCD1.14 (DB7), U1.28
E: LCD1.6 (E), U1.36
GND: C3.2, D1.A, D2.A, LCD1.1 (VSS), LCD1.16 (K), PWR.2, R2.2, R6.1, R11.1, R16.2, RV1.1 (A), U1.GND@2 (GND), U1.GND@3 (GND), U1.GND@4 (GND)
IN: R9.1
unnamed: IC1.5 (+IN), R8.2, R9.2
unnamed: IC1.2 (-IN), R5.2, R6.2
unnamed: IC1.6 (-IN), R10.2, R11.2
unnamed: IC1.3 (+IN), R3.2, R4.2
unnamed: IC1.1 (OUT), R5.1, R7.1
unnamed: IC1.7 (OUT), R10.1, R12.1
unnamed: IC2.1 (OUT), R14.1
unnamed: C3.1, IC2.5 (+IN), R14.2
unnamed: LCD1.3 (VO), RV1.2 (S)
unnamed: LCD1.15 (A), R13.2
OUT: IC2.6 (-IN), IC2.7 (OUT)
PWM: IC2.3 (+IN), U1.9
RS: LCD1.4 (RS), U1.40
RW: LCD1.5 (RW), U1.38
SP: R4.1
VREF: R1.2, R2.1, R3.1, R8.1
VREF2: IC2.2 (-IN), R15.2, R16.1

Notes on the sheet:
ACONDICIONAMIENTO SEÑALES
ACOPLE SALIDA DE CONTROL
ARDUINO MEGA
PANTALLA LCD 16X2
VOLTAJES PWR Y REF

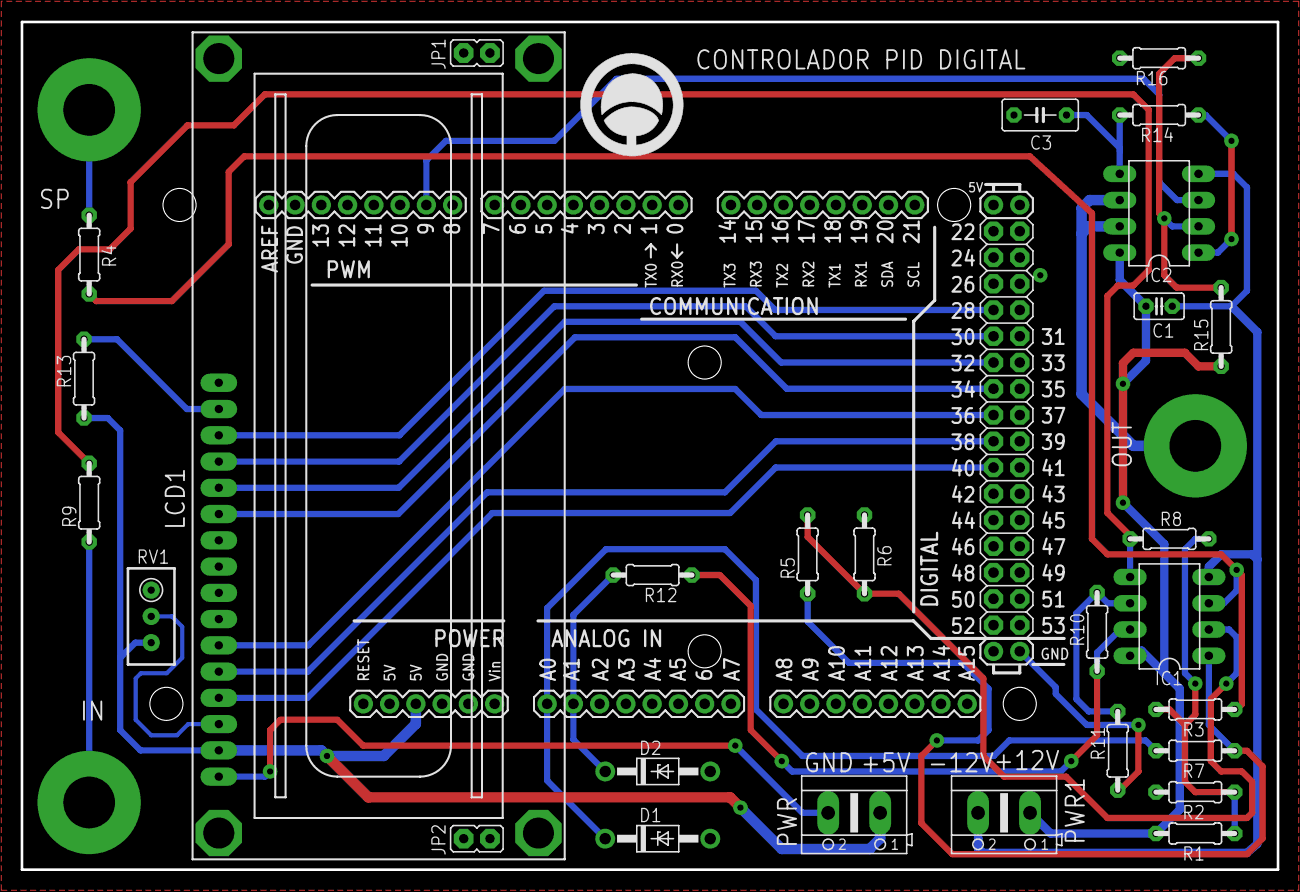
[picture p55: board Controlador PID digital.brd from above]

Board: 2 copper layers, 121.5 x 82.0 mm, 30 parts (0 on the bottom side), 27 nets.
