CaliBeta/Control_PID_modular/Hardware/Eagle/Planta_1 inestable/Planta_1 inestable.brd

## EAGLE design Hardware/Eagle/Planta_1 inestable/Planta_1 inestable.brd (2019-01-15)

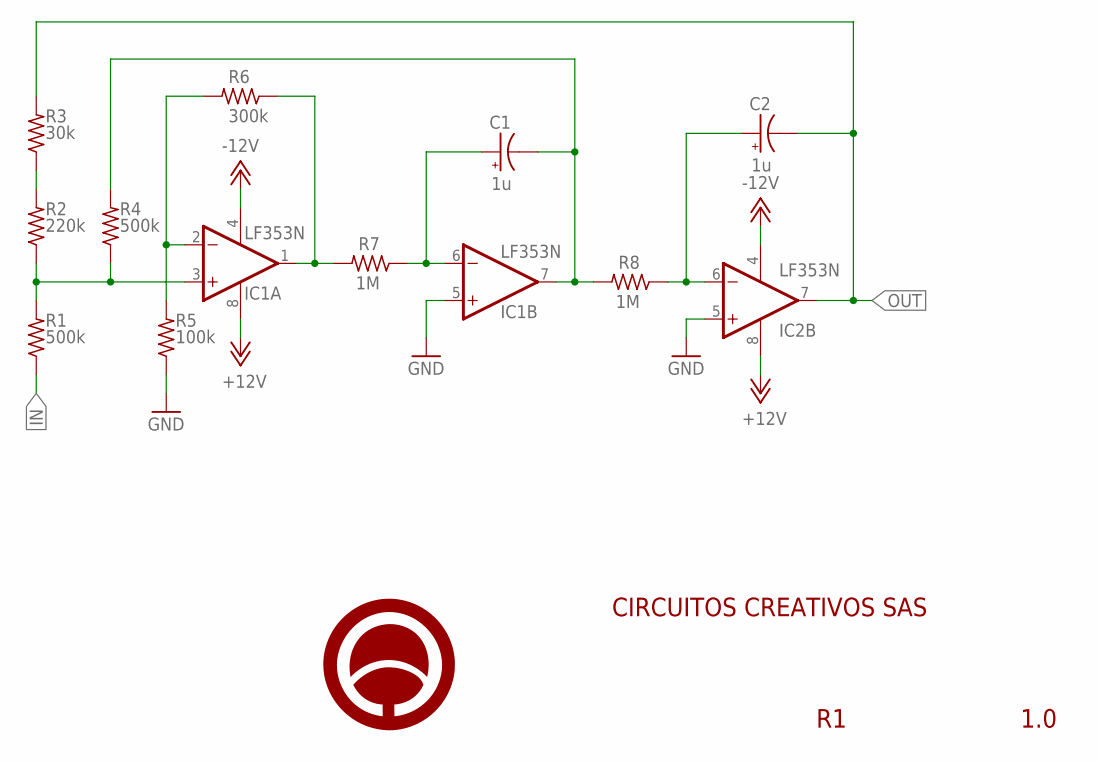
[picture p56: schematic Planta_1 inestable.sch]

Parts:
C1, C2: 1u; E2-5
IC1, IC2: LF353N; DIL08
R1, R4: 500k; 0204/7
R2: 220k; 0204/7
R3: 30k; 0204/7
R5: 100k; 0204/7
R6: 300k; 0204/7
R7, R8: 1M; 0204/7
U$1: LOGO

Connections:
+12V: IC1.8 (V+), IC2.8 (V+)
-12V: IC1.4 (V-), IC2.4 (V-)
GND: IC1.5 (+IN), IC2.5 (+IN), R5.1
IN: R1.1
unnamed: IC1.3 (+IN), R1.2, R2.1, R4.1
unnamed: R2.2, R3.1
unnamed: IC1.2 (-IN), R5.2, R6.2
unnamed: IC1.1 (OUT), R6.1, R7.2
unnamed: C1.+, IC1.6 (-IN), R7.1
unnamed: C1.-, IC1.7 (OUT), R4.2, R8.2
unnamed: C2.+, IC2.6 (-IN), R8.1
OUT: C2.-, IC2.7 (OUT), R3.2

Notes on the sheet:
CIRCUITOS CREATIVOS SAS
1.0

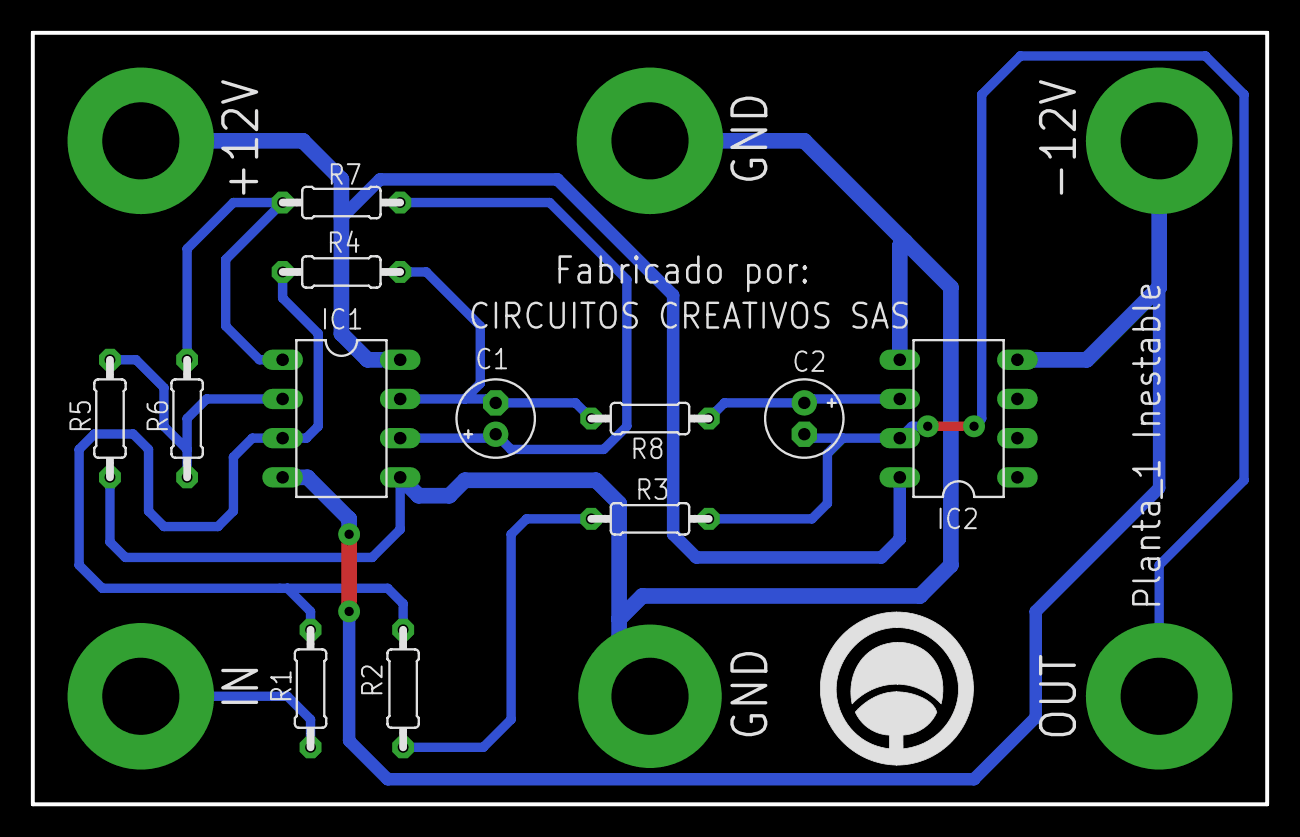
[picture p57: board Planta_1 inestable.brd from above]

Board: 2 copper layers, 80.0 x 50.0 mm, 13 parts (0 on the bottom side), 11 nets.
