CaliBeta/Control_PID_modular/Hardware/Eagle/Fuente de poder/Fuente lineal +12V,-12V,+5V - 500mA.brd

## EAGLE design Hardware/Eagle/Fuente de poder/Fuente lineal +12V,-12V,+5V - 500mA.brd (2019-01-15)

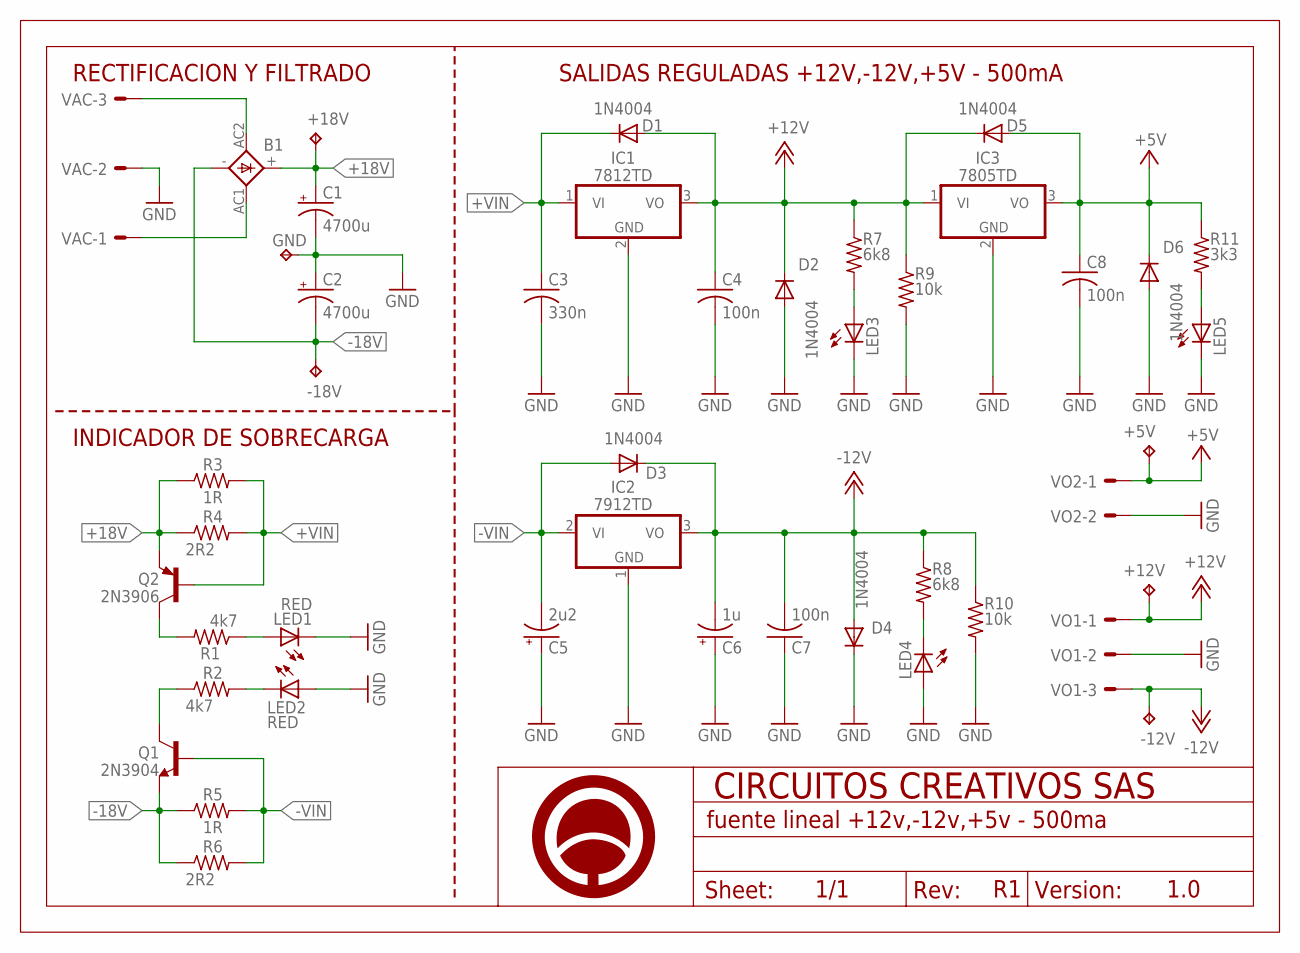
[picture p58: schematic Fuente lineal +12V,-12V,+5V - 500mA.sch]

Parts:
+5V, +12V, +18V: TPPAD1-17; P1-17
-12V, -18V: TPPAD1-17; P1-17
B1: KBL
C1, C2: 4700u; E7,5-16
C3: 330n; C050-030X075
C4, C7, C8: 100n; C050-030X075
C5: 2u2; E2,5-6E
C6: 1u; E2,5-6E
D1, D2, D3, D4, D5, D6: 1N4004; DO41-10
FRAME1: A5_HORIZONTAL; LOGO
GND: TPPAD1-17; P1-17
IC1: 7812TD; TO220VD
IC2: 7912TD; TO220VD
IC3: 7805TD; TO220VD
LED1, LED2: RED; LED5MM
LED3, LED4, LED5: LED5MM
Q1: 2N3904; TO-92
Q2: 2N3906; TO-92
R1, R2: 4k7; 0204/7
R3, R5: 1R; 0922/22
R4, R6: 2R2; 0922/22
R7, R8: 6k8; 0204/7
R9, R10: 10k; 0204/7
R11: 3k3; 0204/7
VAC: KK-156-3
VO1: KK-156-3
VO2: KK-156-2

Connections:
+5V: +5V.TP, C8.1, D5.A, D6.C, IC3.3 (VO), R11.1, VO2.1
+12V: +12V.TP, C4.1, D1.A, D2.C, D5.C, IC1.3 (VO), IC3.1 (VI), R7.1, R9.1, VO1.1
+18V: +18V.TP, B1.+, C1.+, Q2.1 (E), R3.1, R4.1
+VIN: C3.1, D1.C, IC1.1 (VI), Q2.2 (B), R3.2, R4.2
-12V: -12V.TP, C6.-, C7.2, D3.C, D4.A, IC2.3 (VO), R8.1, R10.1, VO1.3
-18V: -18V.TP, B1.-, C2.-, Q1.1 (E), R5.1, R6.1
-VIN: C5.-, D3.A, IC2.2 (VI), Q1.2 (B), R5.2, R6.2
GND: C1.-, C2.+, C3.2, C4.2, C5.+, C6.+, C7.1, C8.2, D2.A, D4.C, D6.A, GND.TP, IC1.2 (GND), IC2.1 (GND), IC3.2 (GND), LED1.K (C), LED2.A, LED3.K (C), LED4.A, LED5.K (C), R9.2, R10.2, VAC.2, VO1.2, VO2.2
unnamed: B1.AC2 (AC1), VAC.3
unnamed: B1.AC1 (AC2), VAC.1
unnamed: Q2.3 (C), R1.2
unnamed: LED4.K (C), R8.2
unnamed: Q1.3 (C), R2.1
unnamed: LED3.A, R7.2
unnamed: LED5.A, R11.2
unnamed: LED1.A, R1.1
unnamed: LED2.K (C), R2.2

Notes on the sheet:
RECTIFICACION Y FILTRADO
INDICADOR DE SOBRECARGA
1.0
SALIDAS REGULADAS +12V,-12V,+5V - 500mA

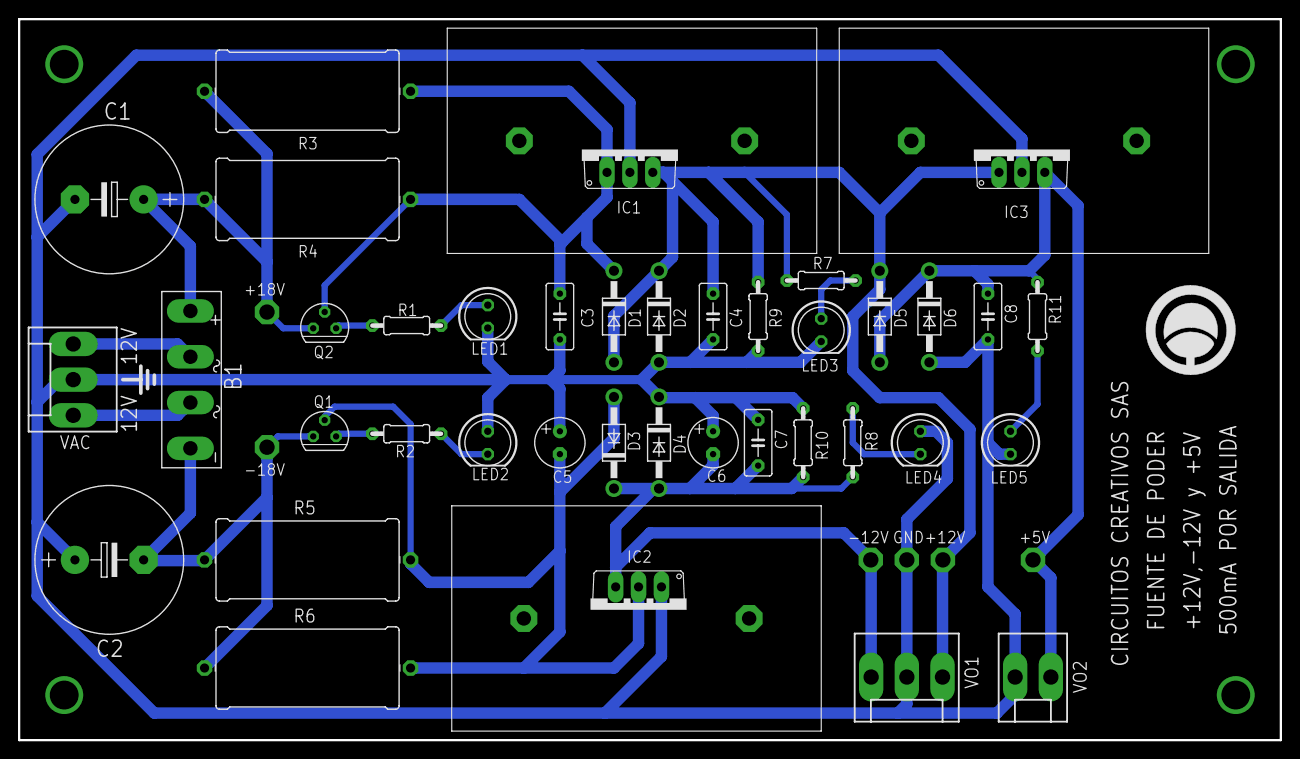
[picture p59: board Fuente lineal +12V,-12V,+5V - 500mA.brd from above]

Board: 2 copper layers, 140.0 x 80.0 mm, 46 parts (0 on the bottom side), 17 nets.
