CaliBeta/Control_PID_modular/Hardware/Eagle/Planta_3 sobreamortiguada/Planta_3 sobreamortiguada.brd

## EAGLE design Hardware/Eagle/Planta_3 sobreamortiguada/Planta_3 sobreamortiguada.brd (2019-01-15)

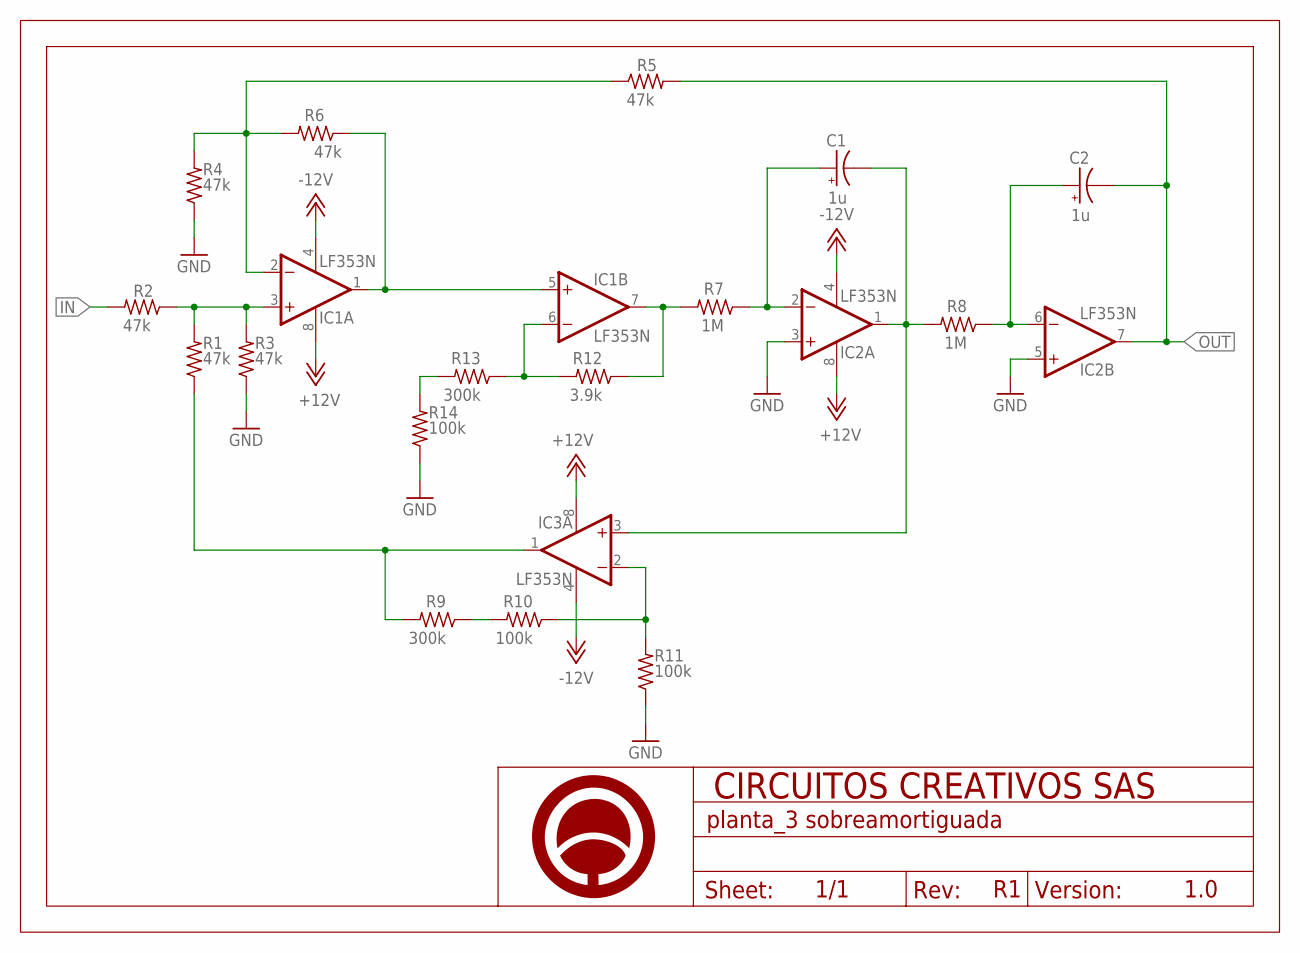
[picture p60: schematic Planta_3 sobreamortiguada.sch]

Parts:
C1, C2: 1u; E2-5
F1: A5_HORIZONTAL; LOGO
IC1, IC2, IC3: LF353N; DIL08
R1, R2, R3, R4, R5, R6: 47k; 0204/7
R7, R8: 1M; 0204/7
R9, R13: 300k; 0204/7
R10, R11, R14: 100k; 0204/7
R12: 3.9k; 0204/7

Connections:
+12V: IC1.8 (V+), IC2.8 (V+), IC3.8 (V+)
-12V: IC1.4 (V-), IC2.4 (V-), IC3.4 (V-)
GND: IC2.3 (+IN), IC2.5 (+IN), R3.1, R4.1, R11.1, R14.1
IN: R2.2
unnamed: IC1.2 (-IN), R4.2, R5.1, R6.2
unnamed: IC1.1 (OUT), IC1.5 (+IN), R6.1
unnamed: C1.+, IC2.2 (-IN), R7.1
unnamed: C1.-, IC2.1 (OUT), IC3.3 (+IN), R8.2
unnamed: C2.+, IC2.6 (-IN), R8.1
unnamed: R9.1, R10.2
unnamed: IC3.1 (OUT), R1.1, R9.2
unnamed: IC3.2 (-IN), R10.1, R11.2
unnamed: IC1.6 (-IN), R12.2, R13.1
unnamed: IC1.7 (OUT), R7.2, R12.1
unnamed: R13.2, R14.2
unnamed: IC1.3 (+IN), R1.2, R2.1, R3.2
OUT: C2.-, IC2.7 (OUT), R5.2

Notes on the sheet:
1.0

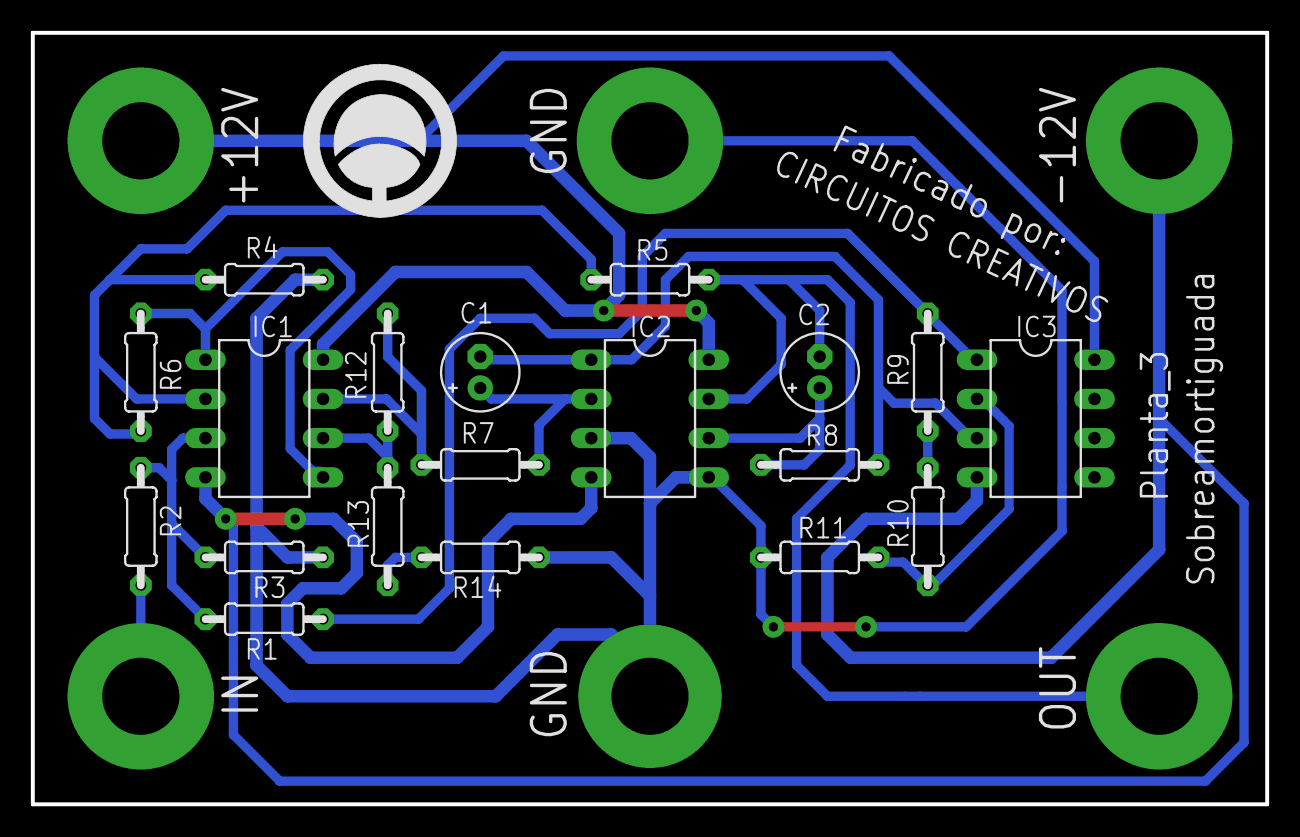
[picture p61: board Planta_3 sobreamortiguada.brd from above]

Board: 2 copper layers, 80.0 x 50.0 mm, 20 parts (0 on the bottom side), 16 nets.
