CaliBeta/Control_PID_modular/Hardware/Eagle/Interface visual/interface visual.brd

## EAGLE design Hardware/Eagle/Interface visual/interface visual.brd (2019-01-15)

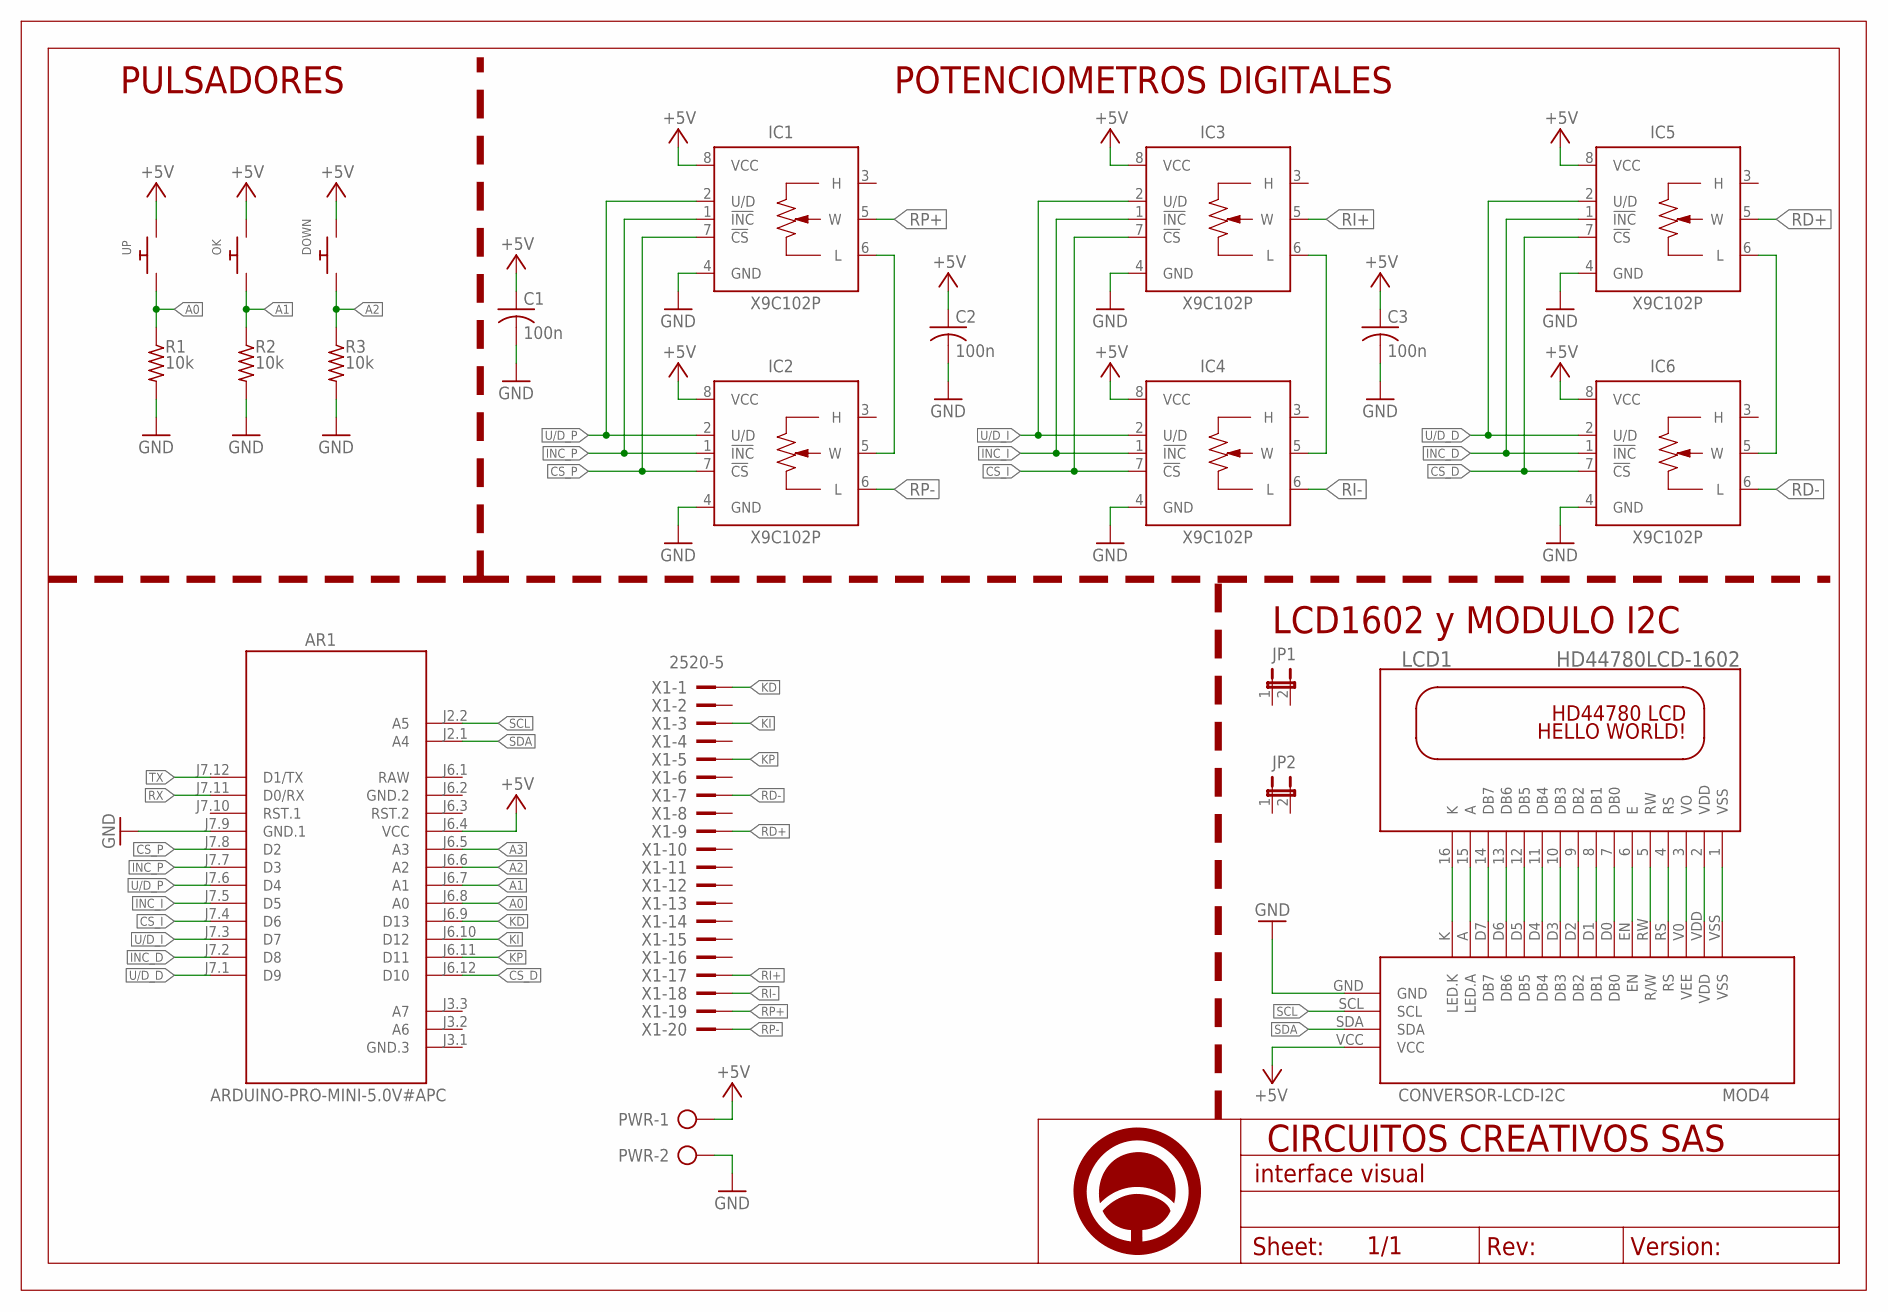
[picture p62: schematic interface visual.sch]

Parts:
AR1: ARDUINO-PRO-MINI-5.0V#APC; ARDUINO-PRO-MINI#APC
C1, C2, C3: 100n; C025-025X050
DOWN: SWITCH_PUSHBUTTONEVQ-PE; TACT_PANA-EVQ
IC1, IC2, IC3, IC4, IC5, IC6: X9C102P; DIL08
JP1, JP2: JP1E; JP1
LCD1: HD44780LCD-1602; LCD1602
MOD4: CONVERSOR-LCD-I2C
OK: SWITCH_PUSHBUTTONEVQ-PE; TACT_PANA-EVQ
PWR: AK500/2
R1, R2, R3: 10k; 0204/7
U$1: A4_HORIZONTAL; LOGO
UP: SWITCH_PUSHBUTTONEVQ-PE; TACT_PANA-EVQ
X1: 2520-5; PAK100/2500-5-20

Connections:
+5V: AR1.J6.4 (VCC), C1.1, C2.1, C3.1, DOWN.P$2, IC1.8 (VCC), IC2.8 (VCC), IC3.8 (VCC), IC4.8 (VCC), IC5.8 (VCC), IC6.8 (VCC), MOD4.VCC, OK.P$2, PWR.1, UP.P$2
A0: AR1.J6.8 (A0), R1.1, UP.P$1
A1: AR1.J6.7 (A1), OK.P$1, R2.1
A2: AR1.J6.6 (A2), DOWN.P$1, R3.1
A3: AR1.J6.5 (A3)
CS_D: AR1.J6.12 (D10), IC5.7 (!CS), IC6.7 (!CS)
CS_I: AR1.J7.4 (D6), IC3.7 (!CS), IC4.7 (!CS)
CS_P: AR1.J7.8 (D2), IC1.7 (!CS), IC2.7 (!CS)
GND: AR1.J7.9 (GND.1), C1.2, C2.2, C3.2, IC1.4 (GND), IC2.4 (GND), IC3.4 (GND), IC4.4 (GND), IC5.4 (GND), IC6.4 (GND), MOD4.GND, PWR.2, R1.2, R2.2, R3.2
GND.2: AR1.J6.2 (GND.2)
INC_D: AR1.J7.2 (D8), IC5.1 (!INC), IC6.1 (!INC)
INC_I: AR1.J7.5 (D5), IC3.1 (!INC), IC4.1 (!INC)
INC_P: AR1.J7.7 (D3), IC1.1 (!INC), IC2.1 (!INC)
KD: AR1.J6.9 (D13), X1.1
KI: AR1.J6.10 (D12), X1.3
KP: AR1.J6.11 (D11), X1.5
unnamed: IC3.6 (L), IC4.5 (W)
unnamed: IC1.6 (L), IC2.5 (W)
unnamed: IC5.6 (L), IC6.5 (W)
unnamed: LCD1.3 (VO), MOD4.V0 (VEE)
unnamed: LCD1.4 (RS), MOD4.RS
unnamed: LCD1.5 (RW), MOD4.RW (R/W)
unnamed: LCD1.7 (DB0), MOD4.D0 (DB0)
unnamed: LCD1.6 (E), MOD4.EN
unnamed: LCD1.8 (DB1), MOD4.D1 (DB1)
unnamed: LCD1.9 (DB2), MOD4.D2 (DB2)
unnamed: LCD1.10 (DB3), MOD4.D3 (DB3)
unnamed: LCD1.11 (DB4), MOD4.D4 (DB4)
unnamed: LCD1.12 (DB5), MOD4.D5 (DB5)
unnamed: LCD1.13 (DB6), MOD4.D6 (DB6)
unnamed: LCD1.14 (DB7), MOD4.D7 (DB7)
unnamed: LCD1.15 (A), MOD4.A (LED.A)
unnamed: LCD1.16 (K), MOD4.K (LED.K)
RAW: AR1.J6.1 (RAW)
RD+: IC5.5 (W), X1.9
RD-: IC6.6 (L), X1.7
RI+: IC3.5 (W), X1.17
RI-: IC4.6 (L), X1.18
RP+: IC1.5 (W), X1.19
RP-: IC2.6 (L), X1.20
RX: AR1.J7.11 (D0/RX)
SCL: AR1.J2.2 (A5), MOD4.SCL
SDA: AR1.J2.1 (A4), MOD4.SDA
TX: AR1.J7.12 (D1/TX)
U/D_D: AR1.J7.1 (D9), IC5.2 (U/D), IC6.2 (U/D)
U/D_I: AR1.J7.3 (D7), IC3.2 (U/D), IC4.2 (U/D)
U/D_P: AR1.J7.6 (D4), IC1.2 (U/D), IC2.2 (U/D)
VDD: LCD1.2 (VDD), MOD4.VDD
VSS: LCD1.1 (VSS), MOD4.VSS

Notes on the sheet:
LCD1602 y MODULO I2C
POTENCIOMETROS DIGITALES
PULSADORES

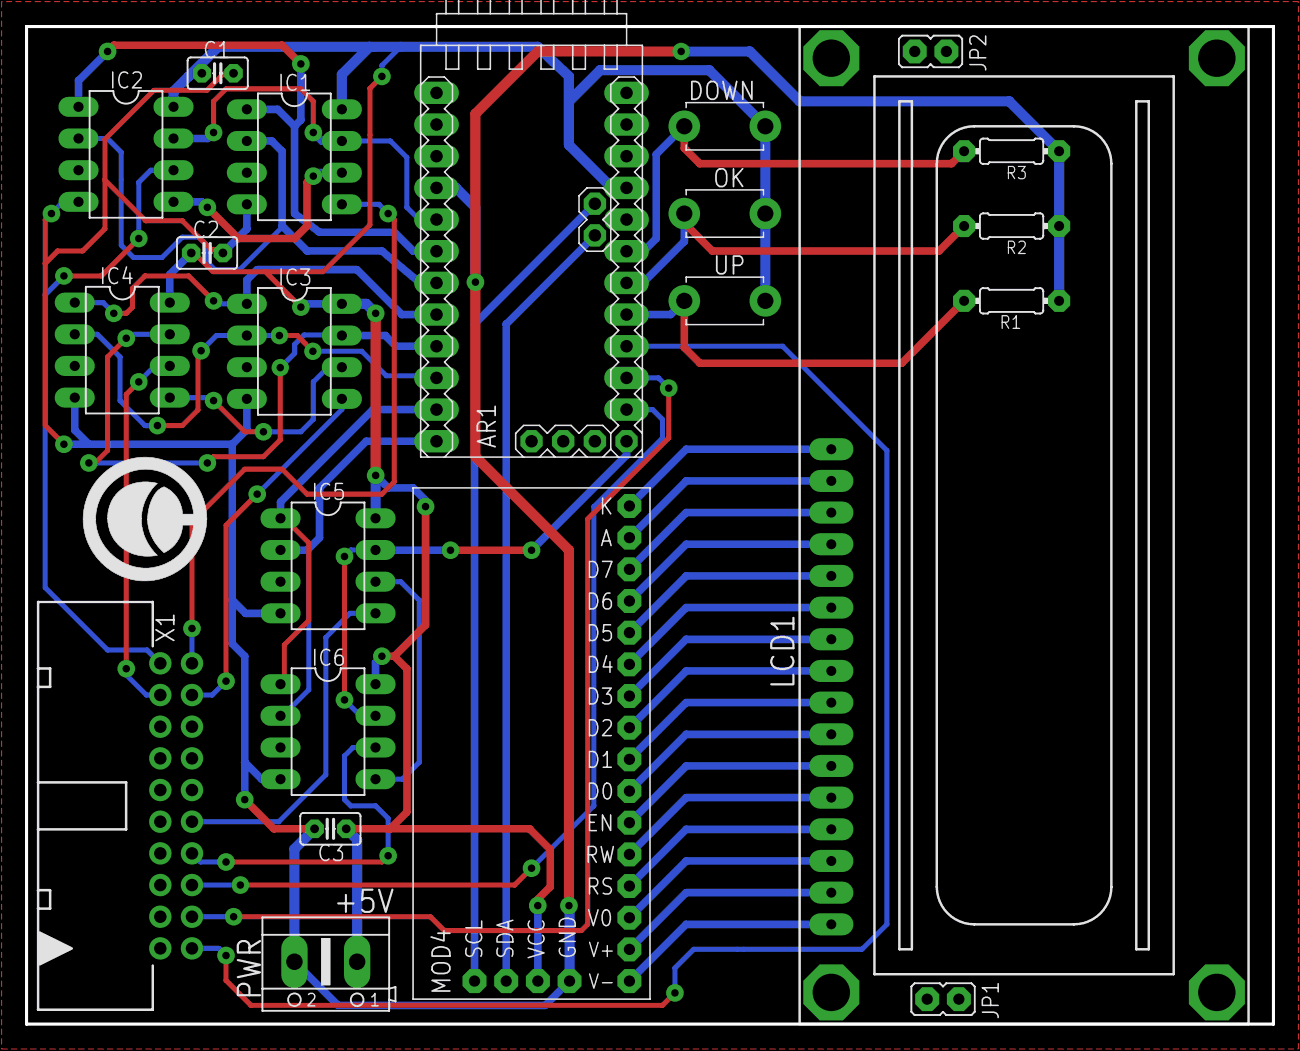
[picture p63: board interface visual.brd from above]

Board: 2 copper layers, 100.0 x 80.0 mm, 23 parts (0 on the bottom side), 44 nets.
