CaliBeta/Control_PID_modular/Hardware/Eagle/Controlador PID Analogico/Controlador PID Analogico.brd

## EAGLE design Hardware/Eagle/Controlador PID Analogico/Controlador PID Analogico.brd (2019-01-15)

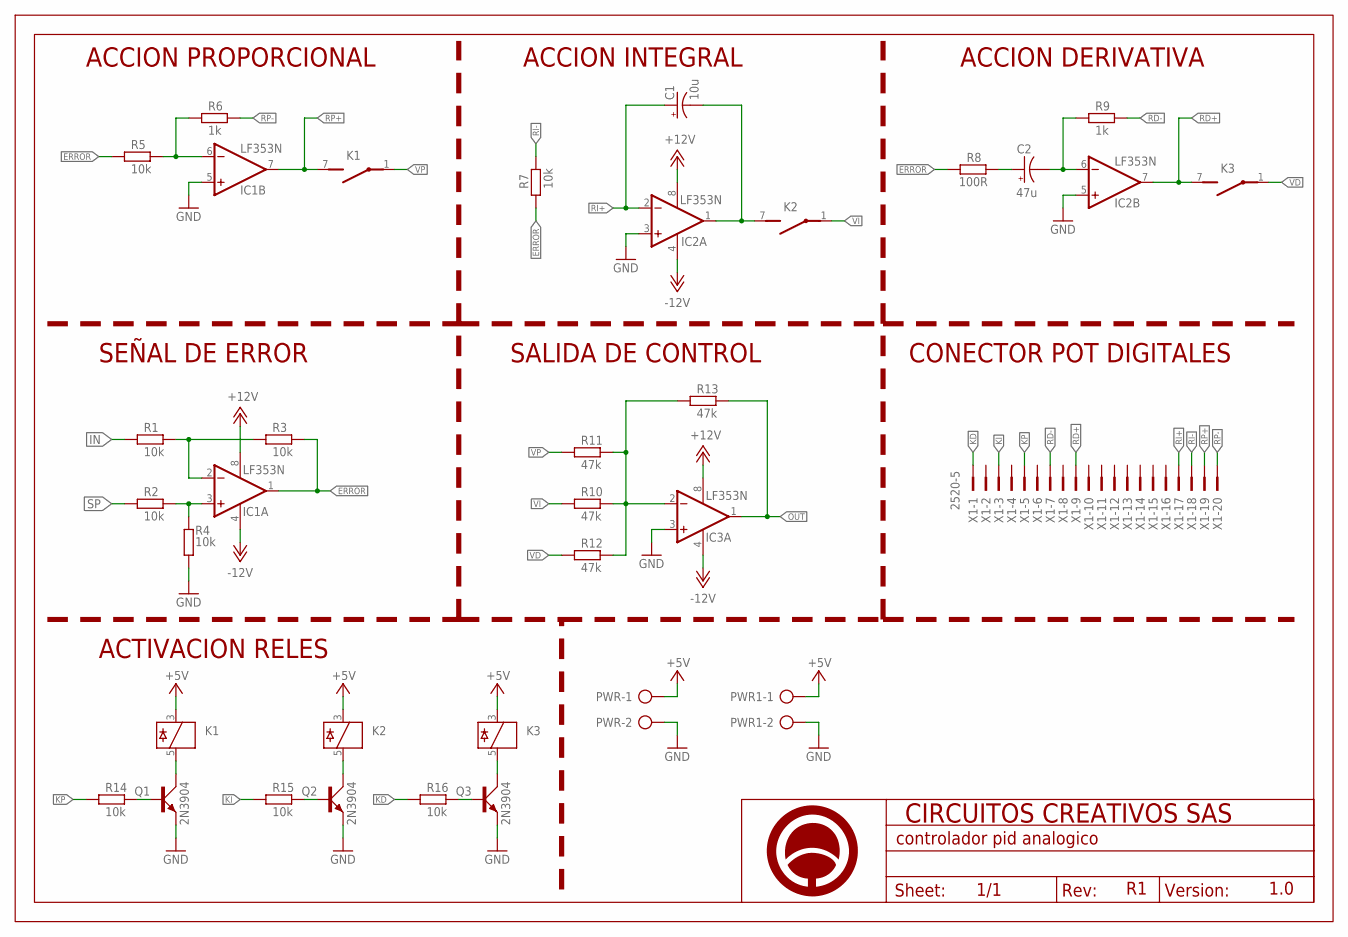
[picture p64: schematic Controlador PID Analogico.sch]

Parts:
C1: 10u; E2,5-6E
C2: 47u; E2,5-6E
IC1, IC2, IC3: LF353N; DIL08
K1, K2, K3: 35701331; REED
PWR, PWR1: AK500/2
Q1, Q2, Q3: 2N3904; TO92D
R1, R2, R3, R4, R5, R7, R14, R15, R16: 10k; 0204/7
R6, R9: 1k; 0204/7
R8: 100R; 0204/7
R10, R11, R12, R13: 47k; 0204/7
U$1: A4_HORIZONTAL; LOGO
X1: 2520-5; PAK100/2500-5-20

Connections:
+5V: K1.3, K2.3, K3.3, PWR.1, PWR1.1
+12V: IC1.8 (V+), IC2.8 (V+), IC3.8 (V+)
-12V: IC1.4 (V-), IC2.4 (V-), IC3.4 (V-)
ERROR: IC1.1 (OUT), R3.2, R5.2, R7.2, R8.1
GND: IC1.5 (+IN), IC2.3 (+IN), IC2.5 (+IN), IC3.3 (+IN), PWR.2, PWR1.2, Q1.E, Q2.E, Q3.E, R4.2
IN: R1.1
KD: R16.1, X1.1
KI: R15.1, X1.3
KP: R14.1, X1.5
unnamed: IC1.2 (-IN), R1.2, R3.1
unnamed: IC1.3 (+IN), R2.2, R4.1
unnamed: IC1.6 (-IN), R5.1, R6.1
unnamed: C1.-, IC2.1 (OUT), K2.7 (S)
unnamed: C2.-, IC2.6 (-IN), R9.1
unnamed: C2.+, R8.2
unnamed: IC3.2 (-IN), R10.2, R11.2, R12.2, R13.1
unnamed: Q1.B, R14.2
unnamed: K1.5, Q1.C
unnamed: Q2.B, R15.2
unnamed: K2.5, Q2.C
unnamed: Q3.B, R16.2
unnamed: K3.5, Q3.C
OUT: IC3.1 (OUT), R13.2
RD+: IC2.7 (OUT), K3.7 (S), X1.9
RD-: R9.2, X1.7
RI+: C1.+, IC2.2 (-IN), X1.17
RI-: R7.1, X1.18
RP+: IC1.7 (OUT), K1.7 (S), X1.19
RP-: R6.2, X1.20
SP: R2.1
VD: K3.1, R12.1
VI: K2.1, R10.1
VP: K1.1, R11.1

Notes on the sheet:
1.0
ACCION PROPORCIONAL
ACCION INTEGRAL
ACCION DERIVATIVA
SEÑAL DE ERROR
SALIDA DE CONTROL
ACTIVACION RELES
CONECTOR POT DIGITALES

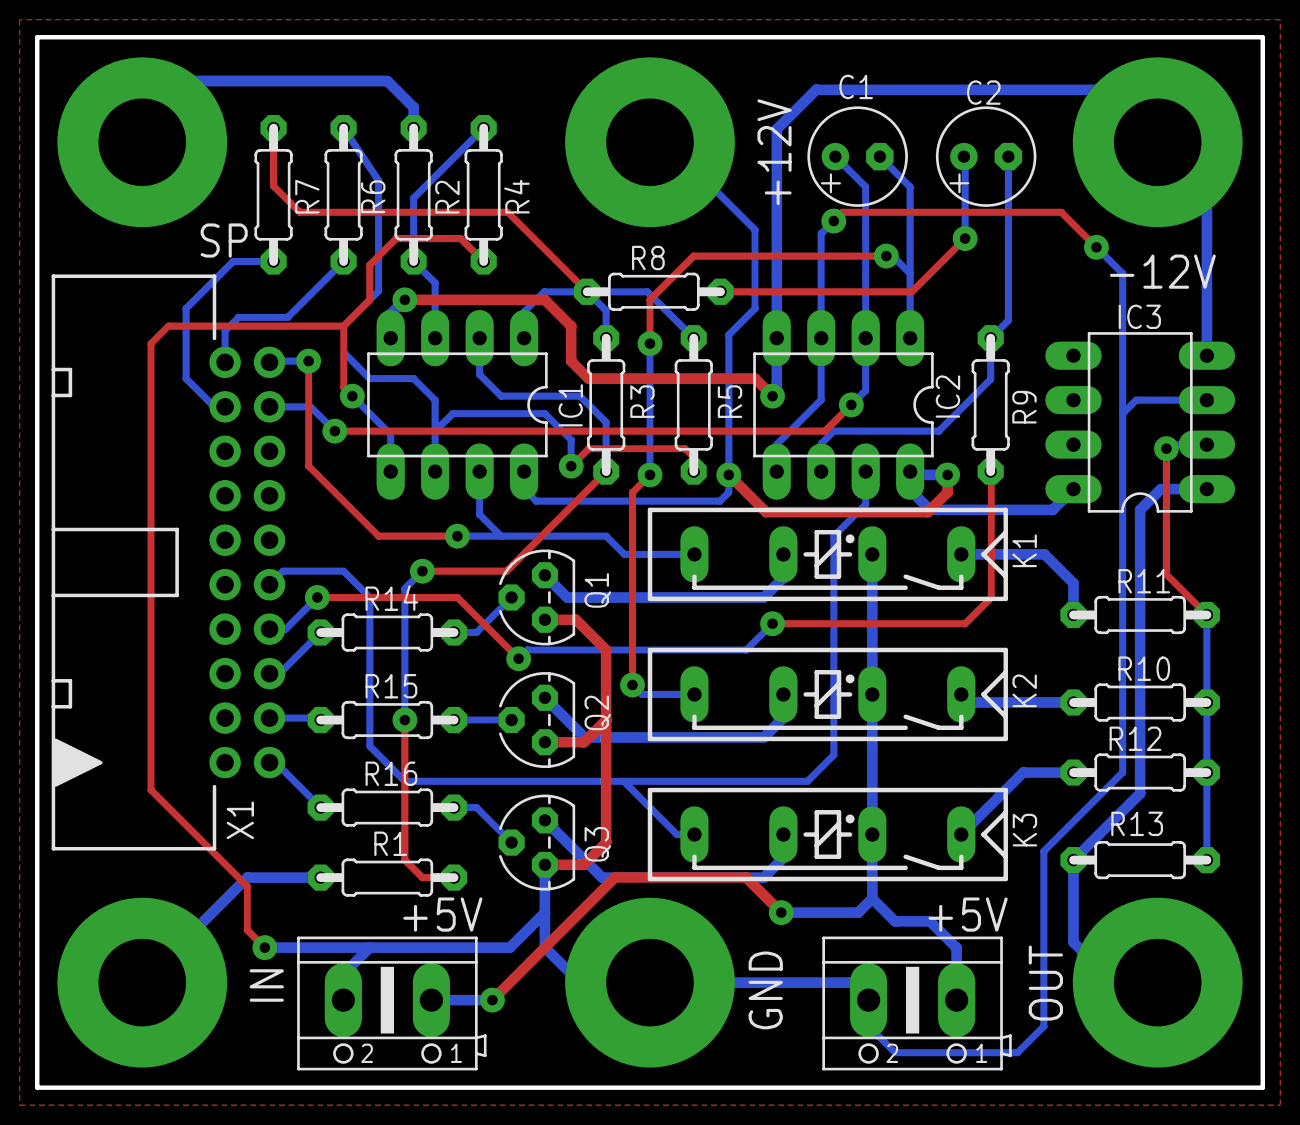
[picture p65: board Controlador PID Analogico.brd from above]

Board: 2 copper layers, 70.0 x 60.0 mm, 31 parts (1 on the bottom side), 31 nets.
