CaliBeta/Control_PID_modular/Hardware/Eagle/Generador de funciones/Generador de funciones.brd

## EAGLE design Hardware/Eagle/Generador de funciones/Generador de funciones.brd (2019-01-15)

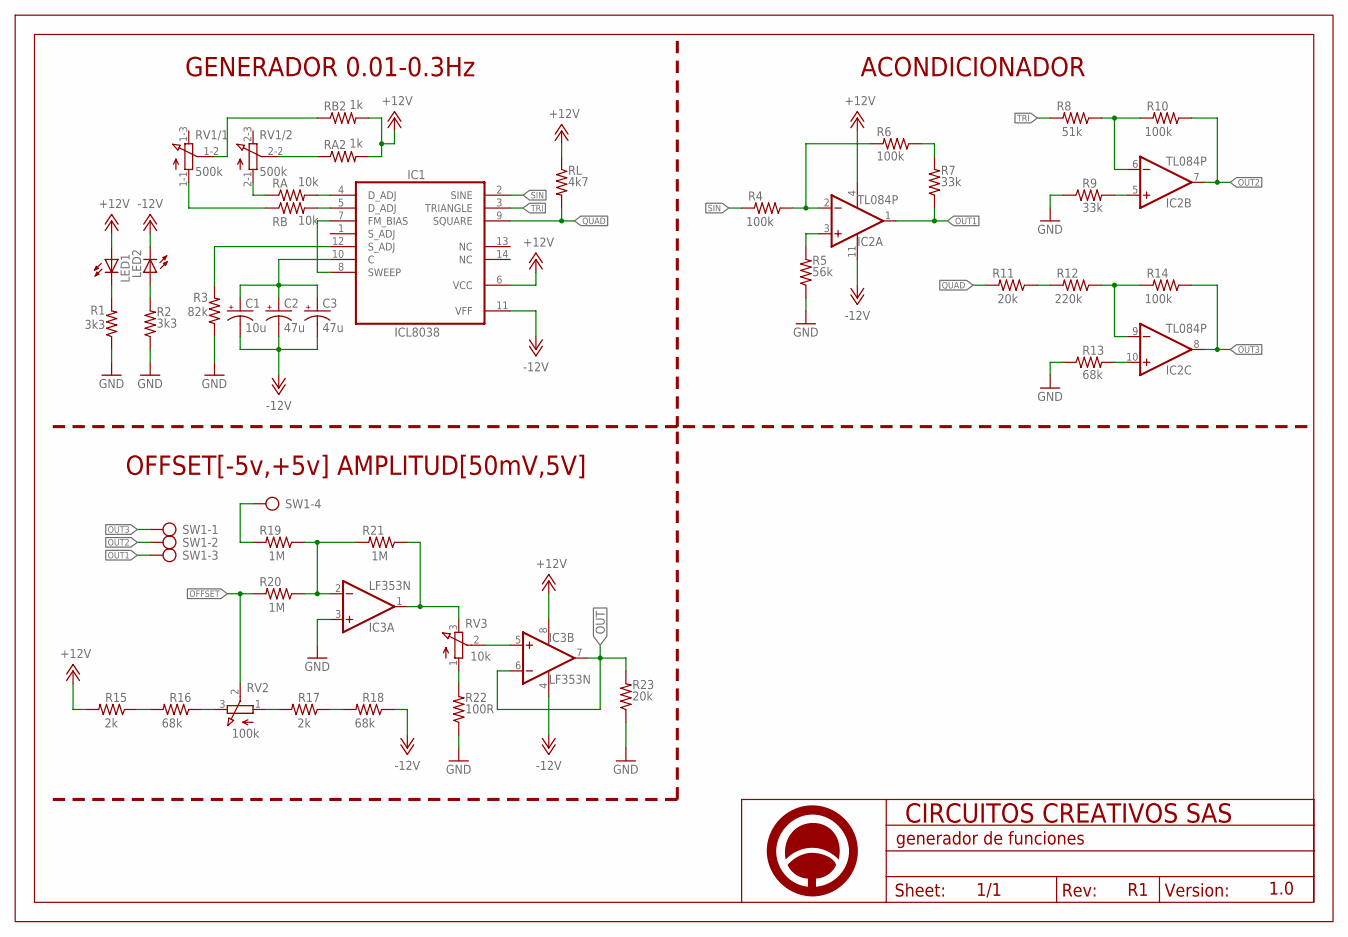
[picture p66: schematic Generador de funciones.sch]

Parts:
C1: 10u; E2-5
C2, C3: 47u; E2-5
FRAME1: A4_HORIZONTAL; LOGO
IC1: ICL8038; DIL14
IC2: TL084P; DIL14
IC3: LF353N; DIL08
LED1, LED2: LED3MM
R1, R2: 3k3; 0204/7
R3: 82k; 0204/7
R4, R6, R10, R14: 100k; 0204/7
R5: 56k; 0204/7
R7, R9: 33k; 0204/7
R8: 51k; 0204/7
R11, R23: 20k; 0204/7
R12: 220k; 0204/7
R13, R16, R18: 68k; 0204/7
R15, R17: 2k; 0204/7
R19, R20, R21: 1M; 0204/7
R22: 100R; 0204/7
RA: 10k; 0204/7
RA2: 1k; 0204/7
RB: 10k; 0204/7
RB2: 1k; 0204/7
RL: 4k7; 0204/7
RV1: 500k; 3RP/1610G
RV2: 100k; 3RP/1610N
RV3: 10k; 3RP/1610N
SW1: AK500/4

Connections:
+12V: IC1.6 (VCC), IC2.4 (V+), IC3.8 (V+), LED1.A, R15.2, RA2.2, RB2.2, RL.1
-12V: C1.-, C2.-, C3.-, IC1.11 (VFF), IC2.11 (V-), IC3.4 (V-), LED2.K (C), R18.1
GND: IC3.3 (+IN), R1.1, R2.1, R3.1, R5.1, R9.1, R13.1, R22.1, R23.1
unnamed: IC1.7 (FM_BIAS), IC1.8 (SWEEP)
unnamed: C1.+, C2.+, C3.+, IC1.10 (C)
unnamed: IC1.12 (S_ADJ), R3.2
unnamed: IC1.4 (D_ADJ), RA.2
unnamed: IC1.5 (D_ADJ), RB.2
unnamed: RA.1, RV1.2-1 (A)
unnamed: RB2.1, RV1.1-2 (S)
unnamed: RB.1, RV1.1-1 (A)
unnamed: RA2.1, RV1.2-2 (S)
unnamed: LED1.K (C), R1.2
unnamed: LED2.A, R2.2
unnamed: IC2.3 (+IN), R5.2
unnamed: IC2.2 (-IN), R4.1, R6.2
unnamed: IC2.9 (-IN), R12.1, R14.2
unnamed: R6.1, R7.2
unnamed: IC2.6 (-IN), R8.1, R10.2
unnamed: IC2.5 (+IN), R9.2
unnamed: IC2.10 (+IN), R13.2
unnamed: R11.1, R12.2
unnamed: R19.2, SW1.4
unnamed: IC3.1 (OUT), R21.1, RV3.3 (E)
unnamed: IC3.2 (-IN), R19.1, R20.1, R21.2
unnamed: R15.1, R16.2
unnamed: R16.1, RV2.3 (E)
unnamed: R17.2, RV2.1 (A)
unnamed: R17.1, R18.2
unnamed: IC3.5 (+IN), RV3.2 (S)
unnamed: R22.2, RV3.1 (A)
OFFSET: R20.2, RV2.2 (S)
OUT: IC3.6 (-IN), IC3.7 (OUT), R23.2
OUT1: IC2.1 (OUT), R7.1, SW1.3
OUT2: IC2.7 (OUT), R10.1, SW1.2
OUT3: IC2.8 (OUT), R14.1, SW1.1
QUAD: IC1.9 (SQUARE), R11.2, RL.2
SIN: IC1.2 (SINE), R4.2
TRI: IC1.3 (TRIANGLE), R8.2

Notes on the sheet:
GENERADOR 0.01-0.3Hz
ACONDICIONADOR
OFFSET[-5v,+5v] AMPLITUD[50mV,5V]
1.0

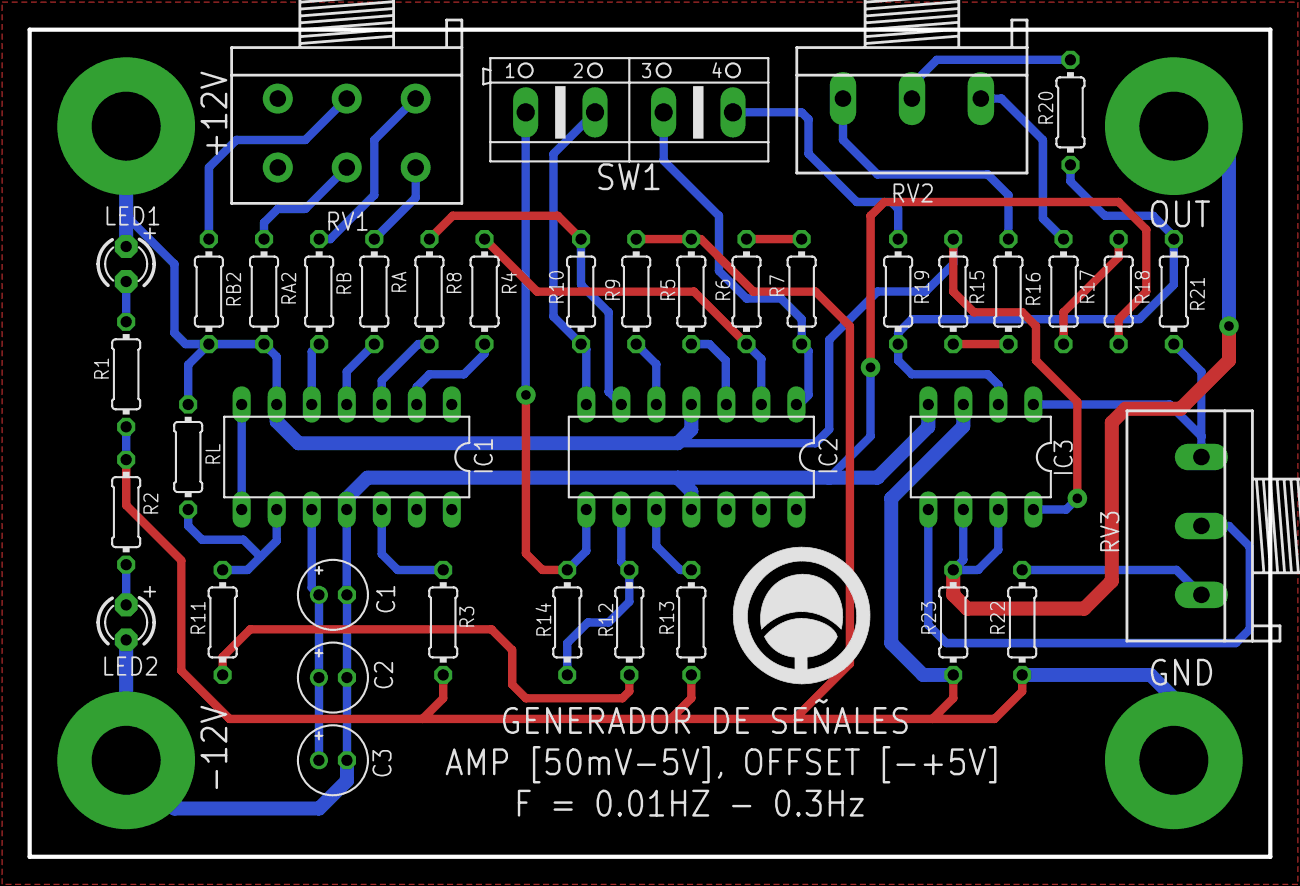
[picture p67: board Generador de funciones.brd from above]

Board: 2 copper layers, 90.0 x 60.0 mm, 41 parts (0 on the bottom side), 39 nets.
