CaliBeta/Control_PID_modular/(commit log)

2019-01-15 Subido simulaciones de Matlab
2019-01-15 Subido simulaciones de Multisim
    [Control_Planta 1.ms14, Control_Planta 2.ms14, Control_Planta 3.ms14, Planta 1.ms14, Planta 2.ms14, Planta 3.ms14]
2019-01-15 Subido simulaciones de Proteus
    [Etapa adecuacion de señales de entrada.pdsprj, Fuente lineal +12V,-12V,+5V-1A.pdsprj, Generador de funciones etapa_01.pdsprj, Generador de funciones etapa_02.pdsprj, Generador de funciones etapa_03.pdsprj, Generador de funciones etapa_final.pdsprj, Salida analogica a partir de PWM.pdsprj]
2019-01-15 Subidos archivos Eagle SCH y BRD
    [Controlador PID Analogico.brd, Controlador PID Analogico.sch, Controlador PID digital.brd, Controlador PID digital.sch, Fuente lineal +12V,-12V,+5V - 500mA.brd, Fuente lineal +12V,-12V,+5V - 500mA.sch, Generador de funciones.brd, Generador de funciones.sch]
2019-01-15 Subido Archivos Gerber
    [Bottom_SolderMask.gbr, Botton_Copper.gbr, Dimension.gbr, Top_Copper.gbr, Top_SilkScreen.gbr, Top_SolderMask.gbr]
2019-01-15 Subido Firmware Arduino
