CaliBeta/Control_PID_modular/(notices)

Notices in the files:
parts and their libraries:
DIY- comercial modules: Released under the Creative Commons Attribution 4.0 International License: http://creativecommons.org/licenses/by/4.0
SparkFun-Boards: Licensing: Creative Commons ShareAlike 4.0 International - https://creativecommons.org/licenses/by-sa/4.0
